scottbez1/Grbl_Esp32/electronics/workbeeController/workbeeController.kicad_pcb

## KiCad design electronics/workbeeController/workbeeController.kicad_pcb (2020-12-29)

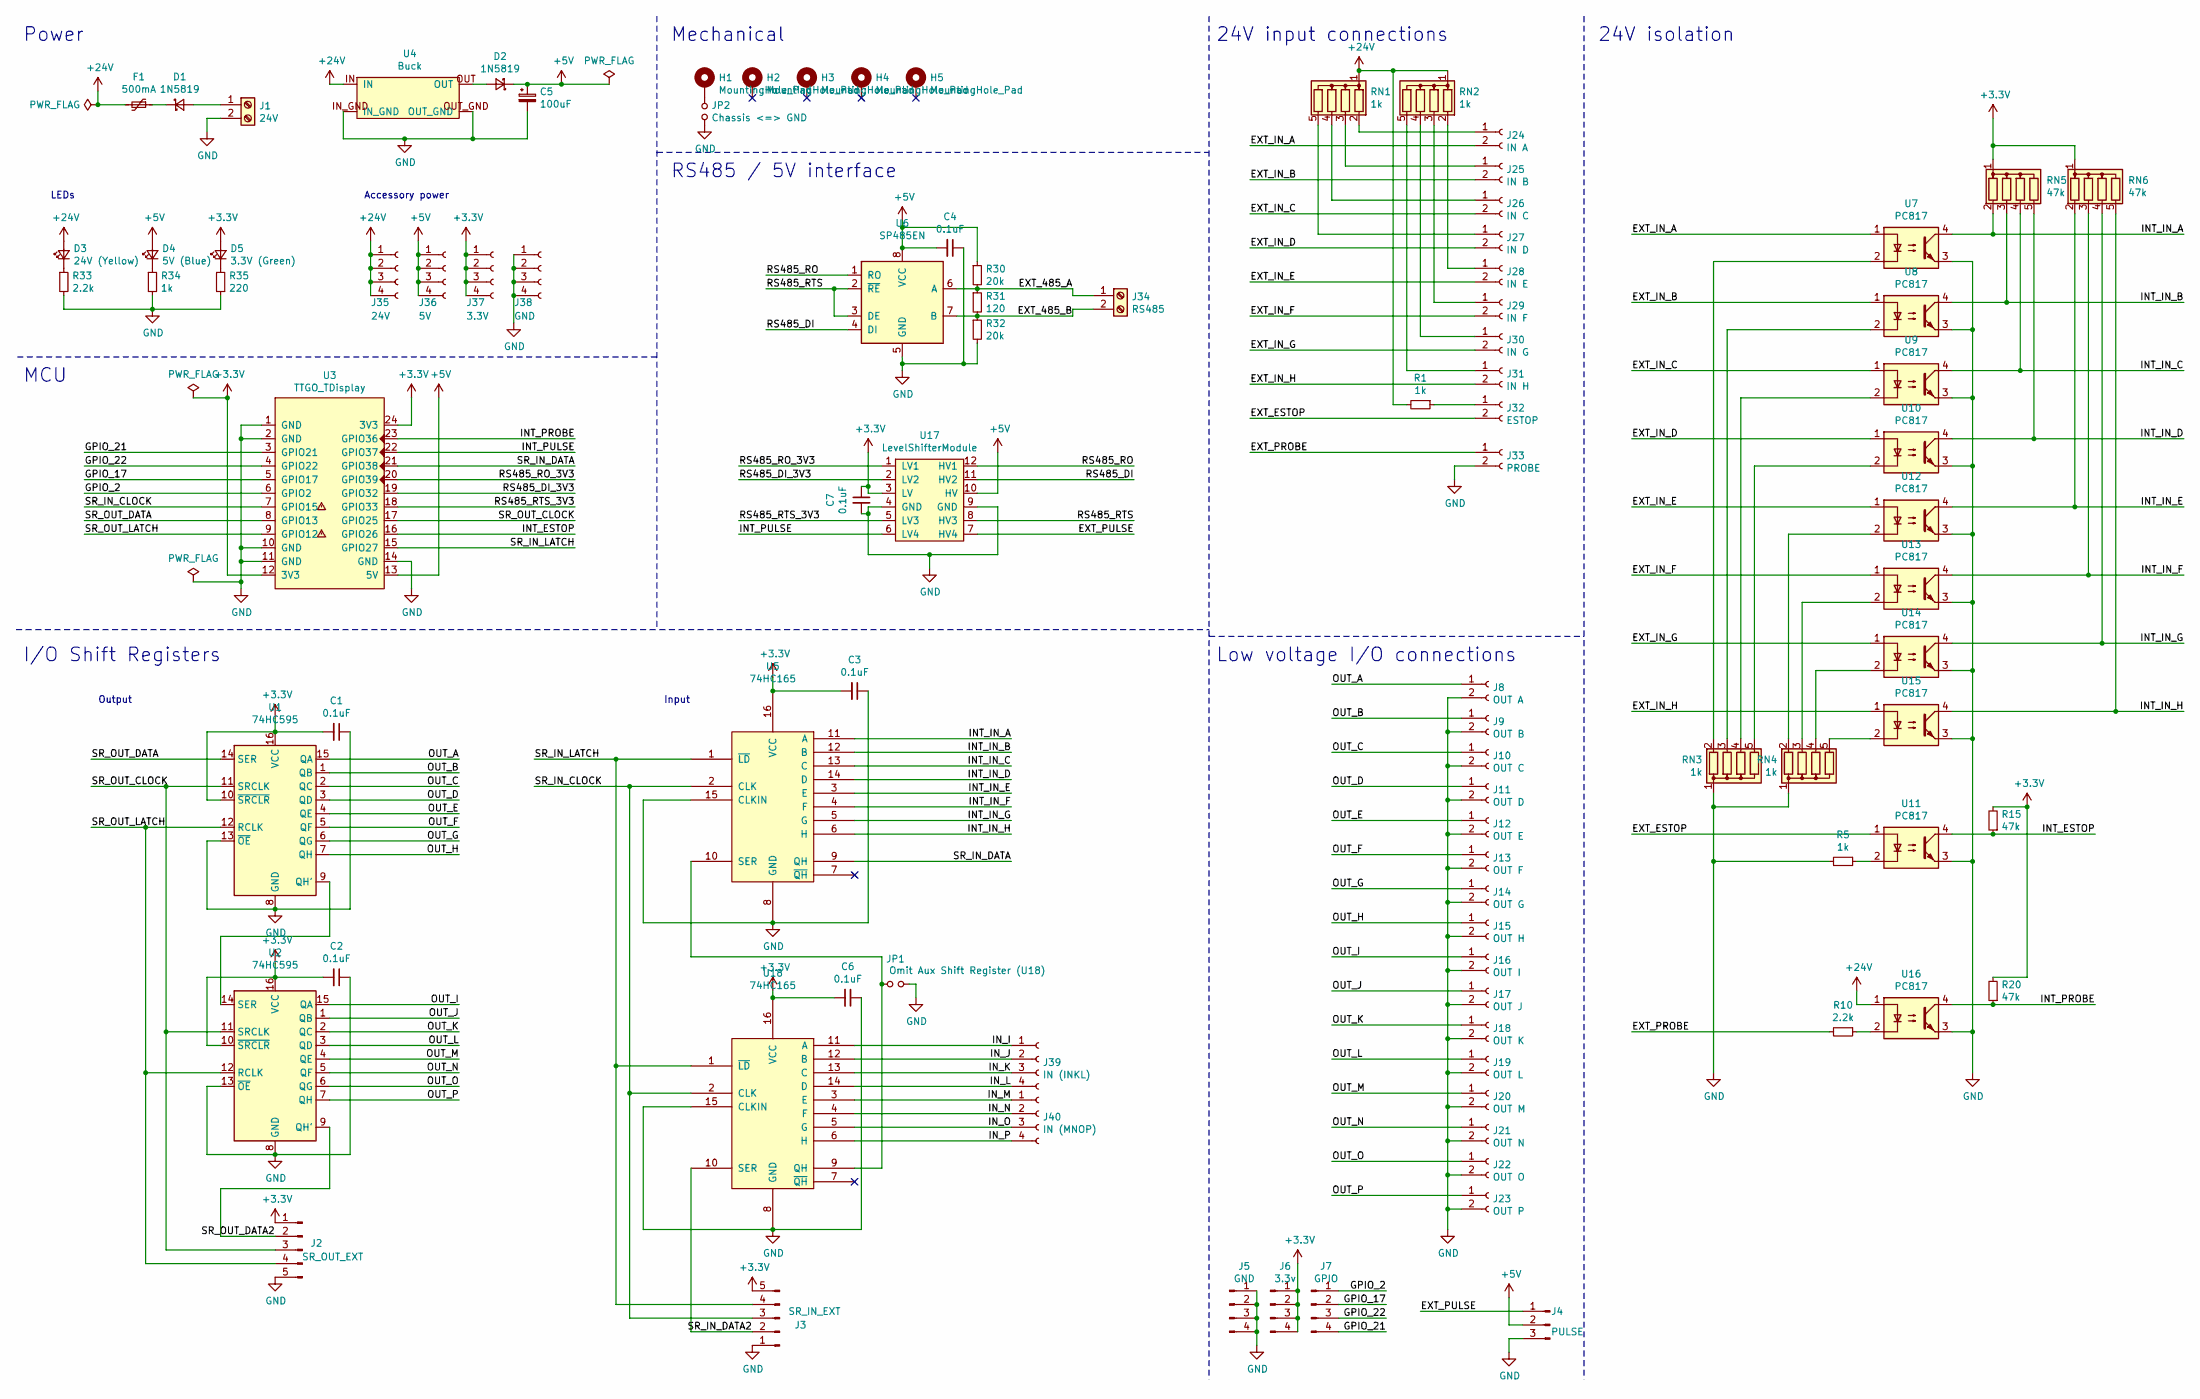
[picture p1: schematic workbeeController.sch]

Parts:
C1, C2, C3, C4, C6, C7: 0.1uF; C_Disc_D5.0mm_W2.5mm_P2.50mm
C5: 100uF; CP_Radial_D8.0mm_P3.50mm
D1, D2: 1N5819; D_DO-41_SOD81_P7.62mm_Horizontal
D3: 24V (Yellow); LED_D3.0mm
D4: 5V (Blue); LED_D3.0mm
D5: 3.3V (Green); LED_D3.0mm
F1: 500mA; C_Disc_D10.5mm_W5.0mm_P5.00mm
H1, H2, H3, H4, H5: MountingHole_Pad; MountingHole_4.3mm_M4_ISO7380_Pad
J1: 24V; 057-EB21A-02-D
J2: SR_OUT_EXT; PinHeader_1x05_P2.54mm_Vertical
J3: SR_IN_EXT; PinHeader_1x05_P2.54mm_Vertical
J4: PULSE; PinHeader_1x03_P2.54mm_Vertical
J5: GND; PinHeader_1x04_P2.54mm_Vertical
J6: 3.3v; PinHeader_1x04_P2.54mm_Vertical
J7: GPIO; PinHeader_1x04_P2.54mm_Vertical
J8: OUT A; PinSocket_1x02_P2.54mm_Vertical
J9: OUT B; PinSocket_1x02_P2.54mm_Vertical
J10: OUT C; PinSocket_1x02_P2.54mm_Vertical
J11: OUT D; PinSocket_1x02_P2.54mm_Vertical
J12: OUT E; PinSocket_1x02_P2.54mm_Vertical
J13: OUT F; PinSocket_1x02_P2.54mm_Vertical
J14: OUT G; PinSocket_1x02_P2.54mm_Vertical
J15: OUT H; PinSocket_1x02_P2.54mm_Vertical
J16: OUT I; PinSocket_1x02_P2.54mm_Vertical
J17: OUT J; PinSocket_1x02_P2.54mm_Vertical
J18: OUT K; PinSocket_1x02_P2.54mm_Vertical
J19: OUT L; PinSocket_1x02_P2.54mm_Vertical
J20: OUT M; PinSocket_1x02_P2.54mm_Vertical
J21: OUT N; PinSocket_1x02_P2.54mm_Vertical
J22: OUT O; PinSocket_1x02_P2.54mm_Vertical
J23: OUT P; PinSocket_1x02_P2.54mm_Vertical
J24: IN A; PinSocket_1x02_P2.54mm_Vertical
J25: IN B; PinSocket_1x02_P2.54mm_Vertical
J26: IN C; PinSocket_1x02_P2.54mm_Vertical
J27: IN D; PinSocket_1x02_P2.54mm_Vertical
J28: IN E; PinSocket_1x02_P2.54mm_Vertical
J29: IN F; PinSocket_1x02_P2.54mm_Vertical
J30: IN G; PinSocket_1x02_P2.54mm_Vertical
J31: IN H; PinSocket_1x02_P2.54mm_Vertical
J32: ESTOP; PinSocket_1x02_P2.54mm_Vertical
J33: PROBE; PinSocket_1x02_P2.54mm_Vertical
J34: RS485; 057-EB21A-02-D
J35: 24V; PinSocket_1x04_P2.54mm_Vertical
J36: 5V; PinSocket_1x04_P2.54mm_Vertical
J37: 3.3V; PinSocket_1x04_P2.54mm_Vertical
J38: GND; PinSocket_1x04_P2.54mm_Vertical
J39: IN (INKL); PinSocket_1x04_P2.54mm_Vertical
J40: IN (MNOP); PinSocket_1x04_P2.54mm_Vertical
JP1: Omit Aux Shift Register (U18); SolderJumper-2_P1.3mm_Open_TrianglePad1.0x1.5mm
JP2: Chassis <=> GND; PinHeader_1x02_P2.54mm_Vertical
R1, R5, R34: 1k; R_Axial_DIN0207_L6.3mm_D2.5mm_P7.62mm_Horizontal
R10, R33: 2.2k; R_Axial_DIN0207_L6.3mm_D2.5mm_P7.62mm_Horizontal
R15, R20: 47k; R_Axial_DIN0207_L6.3mm_D2.5mm_P7.62mm_Horizontal
R30, R32: 20k; R_Axial_DIN0207_L6.3mm_D2.5mm_P7.62mm_Horizontal
R31: 120; R_Axial_DIN0207_L6.3mm_D2.5mm_P7.62mm_Horizontal
R35: 220; R_Axial_DIN0207_L6.3mm_D2.5mm_P7.62mm_Horizontal
RN1, RN2, RN3, RN4: 1k; R_Array_SIP5
RN5, RN6: 47k; R_Array_SIP5
U1, U2: 74HC595; DIP-16_W7.62mm
U3: TTGO_TDisplay; T-DISPLAY
U4: Buck; BuckModule
U5, U18: 74HC165; DIP-16_W7.62mm
U6: SP485EN; SOIC-8_3.9x4.9mm_P1.27mm
U7, U8, U9, U10, U11, U12, U13, U14, U15, U16: PC817; DIP-4_W7.62mm
U17: LevelShifterModule

Connections:
+3V3: C1.2, C2.2, C3.2, C6.2, C7.1, D5.2 (A), J2.1, J3.5, J6.1, J6.2, J6.3, J6.4, J37.1, J37.2, J37.3, J37.4, R15.2, R20.2, RN5.1 (common), RN6.1 (common), U1.10 (~SRCLR), U1.16 (VCC), U2.10 (~SRCLR), U2.16 (VCC), U3.12 (3V3), U3.24 (3V3), U5.16 (VCC), U17.3 (LV), U18.16 (VCC)
+5V: C4.2, C5.1, D2.1 (K), D4.2 (A), J4.2, J36.1, J36.2, J36.3, J36.4, R30.1, U3.13 (5V), U6.8 (VCC), U17.10 (HV)
+24V: D3.2 (A), F1.2, J35.1, J35.2, J35.3, J35.4, R1.2, RN1.1 (common), RN2.1 (common), U4.IN, U16.1
/EXT_485_A: J34.1, R30.2, R31.1, U6.6 (A)
/EXT_485_B: J34.2, R31.2, R32.1, U6.7 (B)
/EXT_ESTOP: J32.2, U11.1
/EXT_IN_A: J24.2, U7.1
/EXT_IN_B: J25.2, U8.1
/EXT_IN_C: J26.2, U9.1
/EXT_IN_D: J27.2, U10.1
/EXT_IN_E: J28.2, U12.1
/EXT_IN_F: J29.2, U13.1
/EXT_IN_G: J30.2, U14.1
/EXT_IN_H: J31.2, U15.1
/EXT_PROBE: J33.1, R10.2
/EXT_PULSE: J4.1, U17.7 (HV4)
/GPIO_2: J7.1, U3.6 (GPIO2)
/GPIO_17: J7.2, U3.5 (GPIO17)
/GPIO_21: J7.4, U3.3 (GPIO21)
/GPIO_22: J7.3, U3.4 (GPIO22)
/INT_ESTOP: R15.1, U3.16 (GPIO26), U11.4
/INT_IN_A: RN5.2 (R1), U5.11 (A), U7.4
/INT_IN_B: RN5.3 (R2), U5.12 (B), U8.4
/INT_IN_C: RN5.4 (R3), U5.13 (C), U9.4
/INT_IN_D: RN5.5 (R4), U5.14 (D), U10.4
/INT_IN_E: RN6.2 (R1), U5.3 (E), U12.4
/INT_IN_F: RN6.3 (R2), U5.4 (F), U13.4
/INT_IN_G: RN6.4 (R3), U5.5 (G), U14.4
/INT_IN_H: RN6.5 (R4), U5.6 (H), U15.4
/INT_PROBE: R20.1, U3.23 (GPIO36), U16.4
/INT_PULSE: U3.22 (GPIO37), U17.6 (LV4)
/IN_I: J39.1, U18.11 (A)
/IN_J: J39.2, U18.12 (B)
/IN_K: J39.3, U18.13 (C)
/IN_L: J39.4, U18.14 (D)
/IN_M: J40.1, U18.3 (E)
/IN_N: J40.2, U18.4 (F)
/IN_O: J40.3, U18.5 (G)
/IN_P: J40.4, U18.6 (H)
/OUT_A: J8.1, U1.15 (QA)
/OUT_B: J9.1, U1.1 (QB)
/OUT_C: J10.1, U1.2 (QC)
/OUT_D: J11.1, U1.3 (QD)
/OUT_E: J12.1, U1.4 (QE)
/OUT_F: J13.1, U1.5 (QF)
/OUT_G: J14.1, U1.6 (QG)
/OUT_H: J15.1, U1.7 (QH)
/OUT_I: J16.1, U2.15 (QA)
/OUT_J: J17.1, U2.1 (QB)
/OUT_K: J18.1, U2.2 (QC)
/OUT_L: J19.1, U2.3 (QD)
/OUT_M: J20.1, U2.4 (QE)
/OUT_N: J21.1, U2.5 (QF)
/OUT_O: J22.1, U2.6 (QG)
/OUT_P: J23.1, U2.7 (QH)
/RS485_DI: U6.4 (DI), U17.11 (HV2)
/RS485_DI_3V3: U3.19 (GPIO32), U17.2 (LV2)
/RS485_RO: U6.1 (RO), U17.12 (HV1)
/RS485_RO_3V3: U3.20 (GPIO39), U17.1 (LV1)
/RS485_RTS: U6.2 (~RE~), U6.3 (DE), U17.8 (HV3)
/RS485_RTS_3V3: U3.18 (GPIO33), U17.5 (LV3)
/SR_IN_CLOCK: J3.3, U3.7 (GPIO15), U5.2 (CLK), U18.2 (CLK)
/SR_IN_DATA: U3.21 (GPIO38), U5.9 (QH)
/SR_IN_DATA2: J3.2, U18.10 (SER)
/SR_IN_LATCH: J3.4, U3.15 (GPIO27), U5.1 (~LD), U18.1 (~LD)
/SR_OUT_CLOCK: J2.3, U1.11 (SRCLK), U2.11 (SRCLK), U3.17 (GPIO25)
/SR_OUT_DATA: U1.14 (SER), U3.8 (GPIO13)
/SR_OUT_DATA2: J2.2, U2.9 (QH')
/SR_OUT_LATCH: J2.4, U1.12 (RCLK), U2.12 (RCLK), U3.9 (GPIO12)
GND: C1.1, C2.1, C3.1, C4.1, C5.2, C6.1, C7.2, J1.2, J2.5, J3.1, J4.3, J5.1, J5.2, J5.3, J5.4, J8.2, J9.2, J10.2, J11.2, J12.2, J13.2, J14.2, J15.2, J16.2, J17.2, J18.2, J19.2, J20.2, J21.2, J22.2, J23.2, J33.2, J38.1, J38.2, J38.3, J38.4, JP1.2, JP2.1, R5.2, R32.2, R33.2, R34.2, R35.2, RN3.1 (common), RN4.1 (common), U1.8 (GND), U1.13 (~OE), U2.8 (GND), U2.13 (~OE), U3.1 (GND), U3.2 (GND), U3.10 (GND), U3.11 (GND), U3.14 (GND), U4.IN_GND, U4.OUT_GND, U5.8 (GND), U5.15 (CLKIN), U6.5 (GND), U7.3, U8.3, U9.3, U10.3, U11.3, U12.3, U13.3, U14.3, U15.3, U16.3, U17.4 (GND), U17.9 (GND), U18.8 (GND), U18.15 (CLKIN)
unnamed: D1.1 (K), F1.1
unnamed: D1.2 (A), J1.1
unnamed: D2.2 (A), U4.OUT
unnamed: D3.1 (K), R33.1
unnamed: D4.1 (K), R34.1
unnamed: D5.1 (K), R35.1
unnamed: H1.1, JP2.2
unnamed: J24.1, RN1.2 (R1)
unnamed: J25.1, RN1.3 (R2)
unnamed: J26.1, RN1.4 (R3)
unnamed: J27.1, RN1.5 (R4)
unnamed: J28.1, RN2.2 (R1)
unnamed: J29.1, RN2.3 (R2)
unnamed: J30.1, RN2.4 (R3)
unnamed: J31.1, RN2.5 (R4)
unnamed: J32.1, R1.1
unnamed: JP1.1, U5.10 (SER), U18.9 (QH)
unnamed: R5.1, U11.2
unnamed: R10.1, U16.2
unnamed: RN3.2 (R1), U7.2
unnamed: RN3.3 (R2), U8.2
unnamed: RN3.4 (R3), U9.2
unnamed: RN3.5 (R4), U10.2
unnamed: RN4.2 (R1), U12.2
unnamed: RN4.3 (R2), U13.2
unnamed: RN4.4 (R3), U14.2
unnamed: RN4.5 (R4), U15.2
unnamed: U1.9 (QH'), U2.14 (SER)

Notes on the sheet:
Power
I/O Shift Registers
MCU
RS485 / 5V interface
24V input connections
Low voltage I/O connections
24V isolation
Accessory power
LEDs
Output
Input
Mechanical

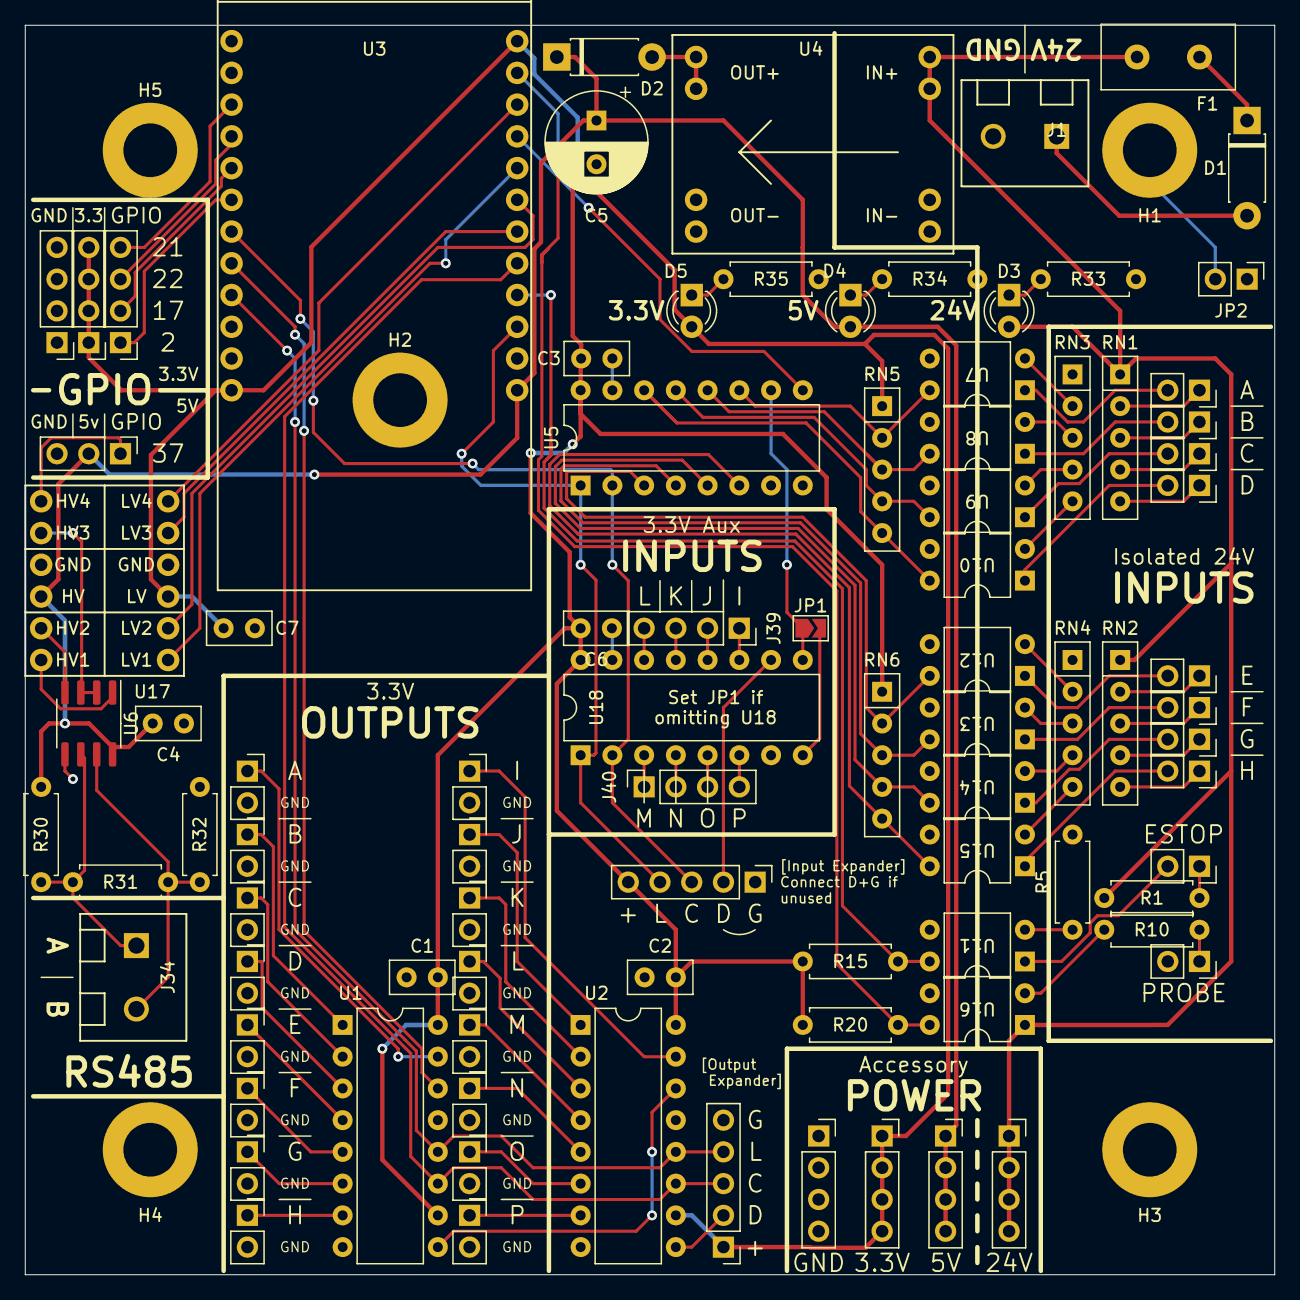
[picture p2: board workbeeController.kicad_pcb from above]

Board: 2 copper layers, 100.0 x 100.0 mm, 95 parts (0 on the bottom side), 98 nets.
