scottbez1/Grbl_Esp32/Grbl_Esp32/src/Defaults.h

#pragma once
#    define DEFAULT_STEP_PULSE_MICROSECONDS 3  // $0
#    define DEFAULT_STEPPER_IDLE_LOCK_TIME 250  // $1 msec (0-254, 255 keeps steppers enabled)
#    define DEFAULT_STEPPING_INVERT_MASK 0  // $2 uint8_t
#    define DEFAULT_DIRECTION_INVERT_MASK 0  // $3 uint8_
#    define DEFAULT_INVERT_ST_ENABLE 0  // $4 boolean
#    define DEFAULT_INVERT_LIMIT_PINS 1  // $5 boolean
#    define DEFAULT_INVERT_PROBE_PIN 0  // $6 boolean
#    define DEFAULT_STATUS_REPORT_MASK 1  // $10
#    define DEFAULT_VERBOSE_ERRORS 0
#    define DEFAULT_JUNCTION_DEVIATION 0.01  // $11 mm
#    define DEFAULT_ARC_TOLERANCE 0.002  // $12 mm
#    define DEFAULT_REPORT_INCHES 0  // $13 false
#    define DEFAULT_SOFT_LIMIT_ENABLE 0  // $20 false
#    define DEFAULT_HARD_LIMIT_ENABLE 0  // $21 false
#    define DEFAULT_HOMING_ENABLE 0  // $22 false
#    define DEFAULT_HOMING_DIR_MASK 3  // $23 move positive dir Z, negative X,Y
#    define DEFAULT_HOMING_FEED_RATE 200.0  // $24 mm/min
#    define DEFAULT_HOMING_SEEK_RATE 2000.0  // $25 mm/min
#    define DEFAULT_HOMING_DEBOUNCE_DELAY 250  // $26 msec (0-65k)
#    define DEFAULT_HOMING_PULLOFF 1.0  // $27 mm
#    define DEFAULT_HOMING_SQUARED_AXES 0
#    define DEFAULT_HOMING_CYCLE_0 bit(Z_AXIS)
#    define DEFAULT_HOMING_CYCLE_1 (bit(X_AXIS) | bit(Y_AXIS))
#    define DEFAULT_HOMING_CYCLE_2 0
#    define DEFAULT_HOMING_CYCLE_3 0
#    define DEFAULT_HOMING_CYCLE_4 0
#    define DEFAULT_HOMING_CYCLE_5 0
#    define SPINDLE_TYPE SpindleType::NONE
#    define DEFAULT_SPINDLE_RPM_MIN 0.0  // rpm
#    define DEFAULT_LASER_MODE 0  // false
#    define DEFAULT_LASER_FULL_POWER 1000
#    define DEFAULT_SPINDLE_RPM_MAX 1000.0  // rpm
#    define DEFAULT_SPINDLE_FREQ 5000.0  // $33 Hz (extended set)
#    define DEFAULT_SPINDLE_OFF_VALUE 0.0  // $34 Percent of full period(extended set)
#    define DEFAULT_SPINDLE_MIN_VALUE 0.0  // $35 Percent of full period (extended set)
#    define DEFAULT_SPINDLE_MAX_VALUE 100.0  // $36 Percent of full period (extended set)
#    define DEFAULT_SPINDLE_DELAY_SPINUP 0
#    define DEFAULT_SPINDLE_DELAY_SPINDOWN 0
#    define DEFAULT_INVERT_SPINDLE_OUTPUT_PIN 0
#    define DEFAULT_INVERT_SPINDLE_ENABLE_PIN 0
#    define DEFAULT_SPINDLE_ENABLE_OFF_WITH_ZERO_SPEED 0
#    define DEFAULT_USER_INT_80 0  // $80 User integer setting
#    define DEFAULT_USER_INT_81 0  // $81 User integer setting
#    define DEFAULT_USER_INT_82 0  // $82 User integer setting
#    define DEFAULT_USER_INT_83 0  // $83 User integer setting
#    define DEFAULT_USER_INT_84 0  // $84 User integer setting
#    define DEFAULT_USER_FLOAT_90 0.0  // $90 User integer setting
#    define DEFAULT_USER_FLOAT_91 0.0  // $92 User integer setting
#    define DEFAULT_USER_FLOAT_92 0.0  // $92 User integer setting
#    define DEFAULT_USER_FLOAT_93 0.0  // $93 User integer setting
#    define DEFAULT_USER_FLOAT_94 0.0  // $94 User integer setting
#    define DEFAULT_X_STEPS_PER_MM 100.0
#    define DEFAULT_Y_STEPS_PER_MM 100.0
#    define DEFAULT_Z_STEPS_PER_MM 100.0
#    define DEFAULT_A_STEPS_PER_MM 100.0
#    define DEFAULT_B_STEPS_PER_MM 100.0
#    define DEFAULT_C_STEPS_PER_MM 100.0
#    define DEFAULT_X_MAX_RATE 1000.0  // mm/min
#    define DEFAULT_Y_MAX_RATE 1000.0  // mm/min
#    define DEFAULT_Z_MAX_RATE 1000.0  // mm/min
#    define DEFAULT_A_MAX_RATE 1000.0  // mm/min
#    define DEFAULT_B_MAX_RATE 1000.0  // mm/min
#    define DEFAULT_C_MAX_RATE 1000.0  // mm/min
#define SEC_PER_MIN_SQ (60.0 * 60.0)  // Seconds Per Minute Squared, for acceleration conversion
#    define DEFAULT_X_ACCELERATION 200.0
#    define DEFAULT_Y_ACCELERATION 200.0
#    define DEFAULT_Z_ACCELERATION 200.0
#    define DEFAULT_A_ACCELERATION 200.0
#    define DEFAULT_B_ACCELERATION 200.0
#    define DEFAULT_C_ACCELERATION 200.0
#    define DEFAULT_X_MAX_TRAVEL 300.0  // $130 mm NOTE: Must be a positive value.
#    define DEFAULT_Y_MAX_TRAVEL 300.0  // mm NOTE: Must be a positive value.
#    define DEFAULT_Z_MAX_TRAVEL 300.0  // mm NOTE: Must be a positive value.
#    define DEFAULT_A_MAX_TRAVEL 300.0  // mm NOTE: Must be a positive value.
#    define DEFAULT_B_MAX_TRAVEL 300.0  // mm NOTE: Must be a positive value.
#    define DEFAULT_C_MAX_TRAVEL 300.0  // mm NOTE: Must be a positive value.
#    define DEFAULT_X_HOMING_MPOS 0.0
#    define DEFAULT_Y_HOMING_MPOS 0.0
#    define DEFAULT_Z_HOMING_MPOS 0.0
#    define DEFAULT_A_HOMING_MPOS 0.0
#    define DEFAULT_B_HOMING_MPOS 0.0
#    define DEFAULT_C_HOMING_MPOS 0.0
#    define DEFAULT_X_CURRENT 0.25  // $140 current in amps (extended set)
#    define DEFAULT_Y_CURRENT 0.25  // $141 current in amps (extended set)
#    define DEFAULT_Z_CURRENT 0.25  // $142 current in amps (extended set)
#    define DEFAULT_A_CURRENT 0.25  // $143 current in amps (extended set)
#    define DEFAULT_B_CURRENT 0.25  // $144 current in amps (extended set)
#    define DEFAULT_C_CURRENT 0.25  // $145 current in amps (extended set)
#    define DEFAULT_X_HOLD_CURRENT 0.125  // $150 current in amps (extended set)
#    define DEFAULT_Y_HOLD_CURRENT 0.125  // $151 current in amps (extended set)
#    define DEFAULT_Z_HOLD_CURRENT 0.125  // $152 current in amps (extended set)
#    define DEFAULT_A_HOLD_CURRENT 0.125  // $153 current in amps (extended set)
#    define DEFAULT_B_HOLD_CURRENT 0.125  // $154 current in amps (extended set)
#    define DEFAULT_C_HOLD_CURRENT 0.125  // $154 current in amps (extended set)
#    define DEFAULT_X_MICROSTEPS 16  // $160 micro steps (extended set)
#    define DEFAULT_Y_MICROSTEPS 16  // $161 micro steps (extended set)
#    define DEFAULT_Z_MICROSTEPS 16  // $162 micro steps (extended set)
#    define DEFAULT_A_MICROSTEPS 16  // $163 micro steps (extended set)
#    define DEFAULT_B_MICROSTEPS 16  // $164 micro steps (extended set)
#    define DEFAULT_C_MICROSTEPS 16  // $165 micro steps (extended set)
#    define DEFAULT_X_STALLGUARD 16  // $170 stallguard (extended set)
#    define DEFAULT_Y_STALLGUARD 16  // $171 stallguard (extended set)
#    define DEFAULT_Z_STALLGUARD 16  // $172 stallguard (extended set)
#    define DEFAULT_A_STALLGUARD 16  // $173 stallguard (extended set)
#    define DEFAULT_B_STALLGUARD 16  // $174 stallguard (extended set)
#    define DEFAULT_C_STALLGUARD 16  // $175 stallguard (extended set)
#    define SDCARD_DET_PIN UNDEFINED_PIN
#    define STEPPERS_DISABLE_PIN UNDEFINED_PIN
#    define X_DISABLE_PIN UNDEFINED_PIN
#    define Y_DISABLE_PIN UNDEFINED_PIN
#    define Z_DISABLE_PIN UNDEFINED_PIN
#    define A_DISABLE_PIN UNDEFINED_PIN
#    define B_DISABLE_PIN UNDEFINED_PIN
#    define C_DISABLE_PIN UNDEFINED_PIN
#    define X2_DISABLE_PIN UNDEFINED_PIN
#    define Y2_DISABLE_PIN UNDEFINED_PIN
#    define Z2_DISABLE_PIN UNDEFINED_PIN
#    define A2_DISABLE_PIN UNDEFINED_PIN
#    define B2_DISABLE_PIN UNDEFINED_PIN
#    define C2_DISABLE_PIN UNDEFINED_PIN
#    define X_LIMIT_PIN UNDEFINED_PIN
#    define Y_LIMIT_PIN UNDEFINED_PIN
#    define Z_LIMIT_PIN UNDEFINED_PIN
#    define A_LIMIT_PIN UNDEFINED_PIN
#    define B_LIMIT_PIN UNDEFINED_PIN
#    define C_LIMIT_PIN UNDEFINED_PIN
#    define X2_LIMIT_PIN UNDEFINED_PIN
#    define Y2_LIMIT_PIN UNDEFINED_PIN
#    define Z2_LIMIT_PIN UNDEFINED_PIN
#    define A2_LIMIT_PIN UNDEFINED_PIN
#    define B2_LIMIT_PIN UNDEFINED_PIN
#    define C2_LIMIT_PIN UNDEFINED_PIN
#    define X_STEPPER_MS3 UNDEFINED_PIN
#    define Y_STEPPER_MS3 UNDEFINED_PIN
#    define Z_STEPPER_MS3 UNDEFINED_PIN
#    define A_STEPPER_MS3 UNDEFINED_PIN
#    define B_STEPPER_MS3 UNDEFINED_PIN
#    define C_STEPPER_MS3 UNDEFINED_PIN
#    define X2_STEPPER_MS3 UNDEFINED_PIN
#    define Y2_STEPPER_MS3 UNDEFINED_PIN
#    define Z2_STEPPER_MS3 UNDEFINED_PIN
#    define A2_STEPPER_MS3 UNDEFINED_PIN
#    define B2_STEPPER_MS3 UNDEFINED_PIN
#    define C2_STEPPER_MS3 UNDEFINED_PIN
#    define SERVO_TIMER_INTERVAL 75.0  // Hz This is the update inveral in milliseconds
#    define DYNAMIXEL_TXD UNDEFINED_PIN
#    define DYNAMIXEL_RXD UNDEFINED_PIN
#    define DYNAMIXEL_RTS UNDEFINED_PIN
#    define USER_DIGITAL_PIN_0 UNDEFINED_PIN
#    define USER_DIGITAL_PIN_1 UNDEFINED_PIN
#    define USER_DIGITAL_PIN_2 UNDEFINED_PIN
#    define USER_DIGITAL_PIN_3 UNDEFINED_PIN
#    define USER_ANALOG_PIN_0 UNDEFINED_PIN
#    define USER_ANALOG_PIN_1 UNDEFINED_PIN
#    define USER_ANALOG_PIN_2 UNDEFINED_PIN
#    define USER_ANALOG_PIN_3 UNDEFINED_PIN
#    define PROBE_PIN UNDEFINED_PIN
#    define USER_ANALOG_PIN_0_FREQ 5000
#    define USER_ANALOG_PIN_1_FREQ 5000
#    define USER_ANALOG_PIN_2_FREQ 5000
#    define USER_ANALOG_PIN_3_FREQ 5000
#    define DEFAULT_USER_MACRO0 ""
#    define DEFAULT_USER_MACRO1 ""
#    define DEFAULT_USER_MACRO2 ""
#    define DEFAULT_USER_MACRO3 ""
