scottbez1/Grbl_Esp32/Grbl_Esp32/src/Machines/workbee.h

#pragma once
// clang-format off

/*
    workbee.h
    Part of Grbl_ESP32

    2018    - Bart Dring
    2020    - Mitch Bradley
    2020    - Scott Bezek

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
    You should have received a copy of the GNU General Public License
    along with Grbl_ESP32.  If not, see <http://www.gnu.org/licenses/>.
*/

#define MACHINE_NAME            "Workbee"

#define USE_MACHINE_INIT


// I2S (steppers & other output-only pins)
#define USE_I2S_OUT
#define USE_I2S_STEPS
#define I2S_OUT_BCK             GPIO_NUM_25
#define I2S_OUT_WS              GPIO_NUM_12
#define I2S_OUT_DATA            GPIO_NUM_13


#define USE_SPI_IN
#define SPI_IN_CLOCK            GPIO_NUM_15
#define SPI_IN_DATA             GPIO_NUM_38
#define SPI_IN_LATCH            GPIO_NUM_27
#define SPI_IN_CLOCK_SPEED_HZ   4000000
#define SPI_IN_DMA_CHANNEL      1
#define SPI_IN_HOST             HSPI_HOST // Note: must use HSPI to avoid conflict with ST7789 driver which uses VSPI

// #define ENABLE_CONTROL_SW_DEBOUNCE
// #define ENABLE_SOFTWARE_DEBOUNCE

// ***** IO *****
#define X_STEP_PIN              I2SO(0)
#define X_DIRECTION_PIN         I2SO(1)
#define Y_STEP_PIN              I2SO(2)
#define Y_DIRECTION_PIN         I2SO(3)
#define Y2_STEP_PIN             I2SO(4)
#define Y2_DIRECTION_PIN        I2SO(5)
#define Z_STEP_PIN              I2SO(6)
#define Z_DIRECTION_PIN         I2SO(7)

#define SPINDLE_TYPE                    SpindleType::HUANYANG
#define VFD_RS485_TXD_PIN               GPIO_NUM_32
#define VFD_RS485_RXD_PIN               GPIO_NUM_39
#define VFD_RS485_RTS_PIN               GPIO_NUM_33
#define VFD_RS485_ADDR                  1
#define DEFAULT_SPINDLE_RPM_MIN         8000.0
#define DEFAULT_SPINDLE_RPM_MAX         24000.0
#define DEFAULT_SPINDLE_DELAY_SPINUP    10000
#define DEFAULT_SPINDLE_DELAY_SPINDOWN  5000

#define SPINDLE_COOLANT_FLOW_PULSE_PIN  GPIO_NUM_37
#define SPINDLE_COOLANT_FLOW_PULSE_UNIT PCNT_UNIT_0

// To debug RS485 spindle comms:
// #define VFD_DEBUG_MODE

#define X_LIMIT_PIN                 SPII(0)
#define Y_LIMIT_PIN                 SPII(1)
#define Y2_LIMIT_PIN                SPII(2)
#define Z_LIMIT_PIN                 SPII(3)
#define DEFAULT_INVERT_LIMIT_PINS   0

#define ESTOP_PIN                   GPIO_NUM_26

#define PROBE_PIN                   GPIO_NUM_36


#define CONTROL_SAFETY_DOOR_PIN     SPII(4)
#define CONTROL_RESET_PIN           SPII(5)
#define CONTROL_FEED_HOLD_PIN       SPII(6)
#define CONTROL_CYCLE_START_PIN     SPII(7)

// The default value in config.h is wrong for this controller
#ifdef INVERT_CONTROL_PIN_MASK
    #undef INVERT_CONTROL_PIN_MASK
#endif
#define INVERT_CONTROL_PIN_MASK B1110


// ***** MACHINE BOUNDS *****
#define DEFAULT_X_MAX_TRAVEL 800.0 // mm
#define DEFAULT_Y_MAX_TRAVEL 1275.0 // mm
#define DEFAULT_Z_MAX_TRAVEL 118.0 // mm

#define DEFAULT_SOFT_LIMIT_ENABLE 1
#define DEFAULT_HARD_LIMIT_ENABLE 0


// ***** MOVEMENT *****
// Invert Y axis
#define DEFAULT_DIRECTION_INVERT_MASK 0b000010

#define DEFAULT_X_STEPS_PER_MM 100.0
#define DEFAULT_Y_STEPS_PER_MM 100.0
#define DEFAULT_Z_STEPS_PER_MM 100.0

#define DEFAULT_X_MAX_RATE 4000.0 // mm/min
#define DEFAULT_Y_MAX_RATE 4000.0 // mm/min
#define DEFAULT_Z_MAX_RATE 3000.0 // mm/min

#define DEFAULT_X_ACCELERATION 500.0 // mm/sec^2
#define DEFAULT_Y_ACCELERATION 500.0 // mm/sec^2
#define DEFAULT_Z_ACCELERATION 100.0 // mm/sec^2


#define PARKING_ENABLE  // Default disabled. Uncomment to enable
#define PARKING_AXIS Z_AXIS                      // Define which axis that performs the parking motion


#define DEFAULT_HOMING_ENABLE           1
#define DEFAULT_HOMING_SQUARED_AXES     (bit(Y_AXIS))
#define DEFAULT_HOMING_DIR_MASK         (bit(X_AXIS))
#define DEFAULT_HOMING_FEED_RATE        100.0 // mm/min
#define DEFAULT_HOMING_SEEK_RATE        2000.0 // mm/min
#define DEFAULT_HOMING_DEBOUNCE_DELAY   25 // msec (0-65k)
#define DEFAULT_HOMING_PULLOFF          2.0 // mm

#define DEFAULT_HOMING_CYCLE_0 (bit(Z_AXIS))  // Raise/home Z before XY motion
#define DEFAULT_HOMING_CYCLE_1 (bit(X_AXIS))  // Home X
#define DEFAULT_HOMING_CYCLE_2 (bit(Y_AXIS))  // Home and sqaure the Y axis (must be done separately from X for squaring)
#define DEFAULT_HOMING_CYCLE_3 0
