scottbez1/Grbl_Esp32/Grbl_Esp32/src/MotionControl.cpp

/*
  MotionControl.cpp - high level interface for issuing motion commands
  Part of Grbl

  Copyright (c) 2011-2016 Sungeun K. Jeon for Gnea Research LLC
  Copyright (c) 2009-2011 Simen Svale Skogsrud

	2018 -	Bart Dring This file was modifed for use on the ESP32
					CPU. Do not use this with Grbl for atMega328P

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
  You should have received a copy of the GNU General Public License
  along with Grbl.  If not, see <http://www.gnu.org/licenses/>.
*/

#include "Grbl.h"

// M_PI is not defined in standard C/C++ but some compilers
// support it anyway.  The following suppresses Intellisense
// problem reports.
#ifndef M_PI
#    define M_PI 3.14159265358979323846
#endif

SquaringMode ganged_mode = SquaringMode::Dual;

// this allows kinematics to be used.
void mc_line_kins(float* target, plan_line_data_t* pl_data, float* position) {
#ifndef USE_KINEMATICS
    mc_line(target, pl_data);
#else  // else use kinematics
    inverse_kinematics(target, pl_data, position);
#endif
}

// Execute linear motion in absolute millimeter coordinates. Feed rate given in millimeters/second
// unless invert_feed_rate is true. Then the feed_rate means that the motion should be completed in
// (1 minute)/feed_rate time.
// NOTE: This is the primary gateway to the grbl planner. All line motions, including arc line
// segments, must pass through this routine before being passed to the planner. The seperation of
// mc_line and plan_buffer_line is done primarily to place non-planner-type functions from being
// in the planner and to let backlash compensation or canned cycle integration simple and direct.
void mc_line(float* target, plan_line_data_t* pl_data) {
    // If enabled, check for soft limit violations. Placed here all line motions are picked up
    // from everywhere in Grbl.
    if (soft_limits->get()) {
        // NOTE: Block jog state. Jogging is a special case and soft limits are handled independently.
        if (sys.state != State::Jog) {
            limits_soft_check(target);
        }
    }
    // If in check gcode mode, prevent motion by blocking planner. Soft limits still work.
    if (sys.state == State::CheckMode) {
        return;
    }
    // NOTE: Backlash compensation may be installed here. It will need direction info to track when
    // to insert a backlash line motion(s) before the intended line motion and will require its own
    // plan_check_full_buffer() and check for system abort loop. Also for position reporting
    // backlash steps will need to be also tracked, which will need to be kept at a system level.
    // There are likely some other things that will need to be tracked as well. However, we feel
    // that backlash compensation should NOT be handled by Grbl itself, because there are a myriad
    // of ways to implement it and can be effective or ineffective for different CNC machines. This
    // would be better handled by the interface as a post-processor task, where the original g-code
    // is translated and inserts backlash motions that best suits the machine.
    // NOTE: Perhaps as a middle-ground, all that needs to be sent is a flag or special command that
    // indicates to Grbl what is a backlash compensation motion, so that Grbl executes the move but
    // doesn't update the machine position values. Since the position values used by the g-code
    // parser and planner are separate from the system machine positions, this is doable.
    // If the buffer is full: good! That means we are well ahead of the robot.
    // Remain in this loop until there is room in the buffer.
    do {
        protocol_execute_realtime();  // Check for any run-time commands
        if (sys.abort) {
            return;  // Bail, if system abort.
        }
        if (plan_check_full_buffer()) {
            protocol_auto_cycle_start();  // Auto-cycle start when buffer is full.
        } else {
            break;
        }
    } while (1);
    // Plan and queue motion into planner buffer
    // uint8_t plan_status; // Not used in normal operation.
    plan_buffer_line(target, pl_data);
}

// Execute an arc in offset mode format. position == current xyz, target == target xyz,
// offset == offset from current xyz, axis_X defines circle plane in tool space, axis_linear is
// the direction of helical travel, radius == circle radius, isclockwise boolean. Used
// for vector transformation direction.
// The arc is approximated by generating a huge number of tiny, linear segments. The chordal tolerance
// of each segment is configured in the arc_tolerance setting, which is defined to be the maximum normal
// distance from segment to the circle when the end points both lie on the circle.
void mc_arc(float*            target,
            plan_line_data_t* pl_data,
            float*            position,
            float*            offset,
            float             radius,
            uint8_t           axis_0,
            uint8_t           axis_1,
            uint8_t           axis_linear,
            uint8_t           is_clockwise_arc) {
    float center_axis0 = position[axis_0] + offset[axis_0];
    float center_axis1 = position[axis_1] + offset[axis_1];
    float r_axis0      = -offset[axis_0];  // Radius vector from center to current location
    float r_axis1      = -offset[axis_1];
    float rt_axis0     = target[axis_0] - center_axis0;
    float rt_axis1     = target[axis_1] - center_axis1;

    float previous_position[MAX_N_AXIS] = { 0.0, 0.0, 0.0, 0.0, 0.0, 0.0 };
#ifdef USE_KINEMATICS

    uint16_t n;
    auto     n_axis = number_axis->get();
    for (n = 0; n < n_axis; n++) {
        previous_position[n] = position[n];
    }
#endif
    // CCW angle between position and target from circle center. Only one atan2() trig computation required.
    float angular_travel = atan2(r_axis0 * rt_axis1 - r_axis1 * rt_axis0, r_axis0 * rt_axis0 + r_axis1 * rt_axis1);
    if (is_clockwise_arc) {  // Correct atan2 output per direction
        if (angular_travel >= -ARC_ANGULAR_TRAVEL_EPSILON) {
            angular_travel -= 2 * M_PI;
        }
    } else {
        if (angular_travel <= ARC_ANGULAR_TRAVEL_EPSILON) {
            angular_travel += 2 * M_PI;
        }
    }
    // NOTE: Segment end points are on the arc, which can lead to the arc diameter being smaller by up to
    // (2x) arc_tolerance. For 99% of users, this is just fine. If a different arc segment fit
    // is desired, i.e. least-squares, midpoint on arc, just change the mm_per_arc_segment calculation.
    // For the intended uses of Grbl, this value shouldn't exceed 2000 for the strictest of cases.
    uint16_t segments = floor(fabs(0.5 * angular_travel * radius) / sqrt(arc_tolerance->get() * (2 * radius - arc_tolerance->get())));
    if (segments) {
        // Multiply inverse feed_rate to compensate for the fact that this movement is approximated
        // by a number of discrete segments. The inverse feed_rate should be correct for the sum of
        // all segments.
        if (pl_data->motion.inverseTime) {
            pl_data->feed_rate *= segments;
            pl_data->motion.inverseTime = 0;  // Force as feed absolute mode over arc segments.
        }
        float theta_per_segment  = angular_travel / segments;
        float linear_per_segment = (target[axis_linear] - position[axis_linear]) / segments;
        /* Vector rotation by transformation matrix: r is the original vector, r_T is the rotated vector,
           and phi is the angle of rotation. Solution approach by Jens Geisler.
               r_T = [cos(phi) -sin(phi);
                      sin(phi)  cos(phi] * r ;

           For arc generation, the center of the circle is the axis of rotation and the radius vector is
           defined from the circle center to the initial position. Each line segment is formed by successive
           vector rotations. Single precision values can accumulate error greater than tool precision in rare
           cases. So, exact arc path correction is implemented. This approach avoids the problem of too many very
           expensive trig operations [sin(),cos(),tan()] which can take 100-200 usec each to compute.

           Small angle approximation may be used to reduce computation overhead further. A third-order approximation
           (second order sin() has too much error) holds for most, if not, all CNC applications. Note that this
           approximation will begin to accumulate a numerical drift error when theta_per_segment is greater than
           ~0.25 rad(14 deg) AND the approximation is successively used without correction several dozen times. This
           scenario is extremely unlikely, since segment lengths and theta_per_segment are automatically generated
           and scaled by the arc tolerance setting. Only a very large arc tolerance setting, unrealistic for CNC
           applications, would cause this numerical drift error. However, it is best to set N_ARC_CORRECTION from a
           low of ~4 to a high of ~20 or so to avoid trig operations while keeping arc generation accurate.

           This approximation also allows mc_arc to immediately insert a line segment into the planner
           without the initial overhead of computing cos() or sin(). By the time the arc needs to be applied
           a correction, the planner should have caught up to the lag caused by the initial mc_arc overhead.
           This is important when there are successive arc motions.
        */
        // Computes: cos_T = 1 - theta_per_segment^2/2, sin_T = theta_per_segment - theta_per_segment^3/6) in ~52usec
        float cos_T = 2.0 - theta_per_segment * theta_per_segment;
        float sin_T = theta_per_segment * 0.16666667 * (cos_T + 4.0);
        cos_T *= 0.5;
        float    sin_Ti;
        float    cos_Ti;
        float    r_axisi;
        uint16_t i;
        uint8_t  count = 0;
        for (i = 1; i < segments; i++) {  // Increment (segments-1).
            if (count < N_ARC_CORRECTION) {
                // Apply vector rotation matrix. ~40 usec
                r_axisi = r_axis0 * sin_T + r_axis1 * cos_T;
                r_axis0 = r_axis0 * cos_T - r_axis1 * sin_T;
                r_axis1 = r_axisi;
                count++;
            } else {
                // Arc correction to radius vector. Computed only every N_ARC_CORRECTION increments. ~375 usec
                // Compute exact location by applying transformation matrix from initial radius vector(=-offset).
                cos_Ti  = cos(i * theta_per_segment);
                sin_Ti  = sin(i * theta_per_segment);
                r_axis0 = -offset[axis_0] * cos_Ti + offset[axis_1] * sin_Ti;
                r_axis1 = -offset[axis_0] * sin_Ti - offset[axis_1] * cos_Ti;
                count   = 0;
            }
            // Update arc_target location
            position[axis_0] = center_axis0 + r_axis0;
            position[axis_1] = center_axis1 + r_axis1;
            position[axis_linear] += linear_per_segment;
#ifdef USE_KINEMATICS
            mc_line_kins(position, pl_data, previous_position);
            previous_position[axis_0]      = position[axis_0];
            previous_position[axis_1]      = position[axis_1];
            previous_position[axis_linear] = position[axis_linear];
#else
            mc_line(position, pl_data);
#endif
            // Bail mid-circle on system abort. Runtime command check already performed by mc_line.
            if (sys.abort) {
                return;
            }
        }
    }
    // Ensure last segment arrives at target location.
    mc_line_kins(target, pl_data, previous_position);
}

// Execute dwell in seconds.
void mc_dwell(float seconds) {
    if (sys.state == State::CheckMode) {
        return;
    }
    protocol_buffer_synchronize();
    delay_sec(seconds, DELAY_MODE_DWELL);
}

// return true if the mask has exactly one bit set,
// so it refers to exactly one axis
static bool mask_is_single_axis(uint8_t axis_mask) {
    // This code depends on the fact that, for binary numberes
    // with only one bit set - and only for such numbers -
    // the bits in one less than the number are disjoint
    // with that bit.  For a number like B100, if you
    // subtract one, the low order 00 bits will have to
    // borrow from the high 1 bit and thus clear it.
    // If any lower bits are 1, then there will be no
    // borrow to clear the highest 1 bit.
    return axis_mask && ((axis_mask & (axis_mask - 1)) == 0);
}

static bool axis_is_squared(uint8_t axis_mask) {
    // Squaring can only be done if it is the only axis in the mask
    if (axis_mask & homing_squared_axes->get()) {
        if (mask_is_single_axis(axis_mask)) {
            return true;
        }
        grbl_msg_sendf(CLIENT_ALL, MsgLevel::Info, "Cannot multi-axis home with squared axes. Homing normally");
        return false;
    }

    return false;
}

#ifdef USE_I2S_STEPS
#    define BACKUP_STEPPER(save_stepper)                                                                                                   \
        do {                                                                                                                               \
            if (save_stepper == ST_I2S_STREAM) {                                                                                           \
                stepper_switch(ST_I2S_STATIC); /* Change the stepper to reduce the delay for accurate probing. */                          \
            }                                                                                                                              \
        } while (0)

#    define RESTORE_STEPPER(save_stepper)                                                                                                  \
        do {                                                                                                                               \
            if (save_stepper == ST_I2S_STREAM && current_stepper != ST_I2S_STREAM) {                                                       \
                stepper_switch(ST_I2S_STREAM); /* Put the stepper back on. */                                                              \
            }                                                                                                                              \
        } while (0)
#else
#    define BACKUP_STEPPER(save_stepper)
#    define RESTORE_STEPPER(save_stepper)
#endif

// Perform homing cycle to locate and set machine zero. Only '$H' executes this command.
// NOTE: There should be no motions in the buffer and Grbl must be in an idle state before
// executing the homing cycle. This prevents incorrect buffered plans after homing.
void mc_homing_cycle(uint8_t cycle_mask) {
    bool no_cycles_defined = true;
#ifdef USE_CUSTOM_HOMING
    if (user_defined_homing(cycle_mask)) {
        return;
    }
#endif
    // This give kinematics a chance to do something before normal homing
    // if it returns true, the homing is canceled.
#ifdef USE_KINEMATICS
    if (kinematics_pre_homing(cycle_mask)) {
        return;
    }
#endif
    // Check and abort homing cycle, if hard limits are already enabled. Helps prevent problems
    // with machines with limits wired on both ends of travel to one limit pin.
    // TODO: Move the pin-specific LIMIT_PIN call to Limits.cpp as a function.
#ifdef LIMITS_TWO_SWITCHES_ON_AXES
    if (limits_get_state()) {
        mc_reset();  // Issue system reset and ensure spindle and coolant are shutdown.
        sys_rt_exec_alarm = ExecAlarm::HardLimit;
        return;
    }
#endif
    limits_disable();  // Disable hard limits pin change register for cycle duration
    // -------------------------------------------------------------------------------------
    // Perform homing routine. NOTE: Special motion case. Only system reset works.
    n_homing_locate_cycle = NHomingLocateCycle;
#ifdef HOMING_SINGLE_AXIS_COMMANDS
    /*
    if (cycle_mask) { limits_go_home(cycle_mask); } // Perform homing cycle based on mask.
    else
    */
    if (cycle_mask) {
        if (!axis_is_squared(cycle_mask)) {
            limits_go_home(cycle_mask);  // Homing cycle 0
        } else {
            ganged_mode           = SquaringMode::Dual;
            n_homing_locate_cycle = 0;  // don't do a second touch cycle
            limits_go_home(cycle_mask);
            ganged_mode           = SquaringMode::A;
            n_homing_locate_cycle = NHomingLocateCycle;  // restore to default value
            limits_go_home(cycle_mask);
            ganged_mode = SquaringMode::B;
            limits_go_home(cycle_mask);
            ganged_mode = SquaringMode::Dual;  // always return to dual
        }
    }  // Perform homing cycle based on mask.
    else
#endif
    {
        for (int cycle = 0; cycle < MAX_N_AXIS; cycle++) {
            auto homing_mask = homing_cycle[cycle]->get();
            if (homing_mask) {  // if there are some axes in this cycle
                no_cycles_defined = false;
                if (!axis_is_squared(homing_mask)) {
                    limits_go_home(homing_mask);  // Homing cycle 0
                } else {
                    ganged_mode           = SquaringMode::Dual;
                    n_homing_locate_cycle = 0;  // don't do a second touch cycle
                    limits_go_home(homing_mask);
                    ganged_mode           = SquaringMode::A;
                    n_homing_locate_cycle = NHomingLocateCycle;  // restore to default value
                    limits_go_home(homing_mask);
                    ganged_mode = SquaringMode::B;
                    limits_go_home(homing_mask);
                    ganged_mode = SquaringMode::Dual;  // always return to dual
                }
            }
        }
        if (no_cycles_defined) {
            report_status_message(Error::HomingNoCycles, CLIENT_ALL);
        }
    }
    protocol_execute_realtime();  // Check for reset and set system abort.
    if (sys.abort) {
        return;  // Did not complete. Alarm state set by mc_alarm.
    }
    // Homing cycle complete! Setup system for normal operation.
    // -------------------------------------------------------------------------------------
    // Sync gcode parser and planner positions to homed position.
    gc_sync_position();
    plan_sync_position();
#ifdef USE_KINEMATICS
    // This give kinematics a chance to do something after normal homing
    kinematics_post_homing();
#endif
    // If hard limits feature enabled, re-enable hard limits pin change register after homing cycle.
    limits_init();
}

// Perform tool length probe cycle. Requires probe switch.
// NOTE: Upon probe failure, the program will be stopped and placed into ALARM state.
GCUpdatePos mc_probe_cycle(float* target, plan_line_data_t* pl_data, uint8_t parser_flags) {
    // TODO: Need to update this cycle so it obeys a non-auto cycle start.
    if (sys.state == State::CheckMode) {
#ifdef SET_CHECK_MODE_PROBE_TO_START
        return GCUpdatePos::None;
#else
        return GCUpdatePos::Target;
#endif
    }
    // Finish all queued commands and empty planner buffer before starting probe cycle.
    protocol_buffer_synchronize();
    if (sys.abort) {
        return GCUpdatePos::None;  // Return if system reset has been issued.
    }

#ifdef USE_I2S_STEPS
    stepper_id_t save_stepper = current_stepper; /* remember the stepper */
#endif
    // Switch stepper mode to the I2S static (realtime mode)
    BACKUP_STEPPER(save_stepper);

    // Initialize probing control variables
    uint8_t is_probe_away = bit_istrue(parser_flags, GCParserProbeIsAway);
    uint8_t is_no_error   = bit_istrue(parser_flags, GCParserProbeIsNoError);
    sys.probe_succeeded   = false;  // Re-initialize probe history before beginning cycle.
    set_probe_direction(is_probe_away);
    // After syncing, check if probe is already triggered. If so, halt and issue alarm.
    // NOTE: This probe initialization error applies to all probing cycles.
    if (probe_get_state() ^ is_probe_away) {  // Check probe pin state.
        sys_rt_exec_alarm = ExecAlarm::ProbeFailInitial;
        protocol_execute_realtime();
        RESTORE_STEPPER(save_stepper);  // Switch the stepper mode to the previous mode
        return GCUpdatePos::None;       // Nothing else to do but bail.
    }
    // Setup and queue probing motion. Auto cycle-start should not start the cycle.
    grbl_msg_sendf(CLIENT_SERIAL, MsgLevel::Info, "Found");
    mc_line_kins(target, pl_data, gc_state.position);
    // Activate the probing state monitor in the stepper module.
    sys_probe_state = Probe::Active;
    // Perform probing cycle. Wait here until probe is triggered or motion completes.
    sys_rt_exec_state.bit.cycleStart = true;
    do {
        protocol_execute_realtime();
        if (sys.abort) {
            RESTORE_STEPPER(save_stepper);  // Switch the stepper mode to the previous mode
            return GCUpdatePos::None;       // Check for system abort
        }
    } while (sys.state != State::Idle);

    // Switch the stepper mode to the previous mode
    RESTORE_STEPPER(save_stepper);

    // Probing cycle complete!
    // Set state variables and error out, if the probe failed and cycle with error is enabled.
    if (sys_probe_state == Probe::Active) {
        if (is_no_error) {
            memcpy(sys_probe_position, sys_position, sizeof(sys_position));
        } else {
            sys_rt_exec_alarm = ExecAlarm::ProbeFailContact;
        }
    } else {
        sys.probe_succeeded = true;  // Indicate to system the probing cycle completed successfully.
    }
    sys_probe_state = Probe::Off;  // Ensure probe state monitor is disabled.
    protocol_execute_realtime();   // Check and execute run-time commands
    // Reset the stepper and planner buffers to remove the remainder of the probe motion.
    st_reset();            // Reset step segment buffer.
    plan_reset();          // Reset planner buffer. Zero planner positions. Ensure probing motion is cleared.
    plan_sync_position();  // Sync planner position to current machine position.
#ifdef MESSAGE_PROBE_COORDINATES
    // All done! Output the probe position as message.
    report_probe_parameters(CLIENT_ALL);
#endif
    if (sys.probe_succeeded) {
        return GCUpdatePos::System;  // Successful probe cycle.
    } else {
        return GCUpdatePos::Target;  // Failed to trigger probe within travel. With or without error.
    }
}

// Plans and executes the single special motion case for parking. Independent of main planner buffer.
// NOTE: Uses the always free planner ring buffer head to store motion parameters for execution.
void mc_parking_motion(float* parking_target, plan_line_data_t* pl_data) {
    if (sys.abort) {
        return;  // Block during abort.
    }
    uint8_t plan_status = plan_buffer_line(parking_target, pl_data);
    if (plan_status) {
        sys.step_control.executeSysMotion = true;
        sys.step_control.endMotion        = false;  // Allow parking motion to execute, if feed hold is active.
        st_parking_setup_buffer();                  // Setup step segment buffer for special parking motion case
        st_prep_buffer();
        st_wake_up();
        do {
            protocol_exec_rt_system();
            if (sys.abort) {
                return;
            }
        } while (sys.step_control.executeSysMotion);
        st_parking_restore_buffer();  // Restore step segment buffer to normal run state.
    } else {
        sys.step_control.executeSysMotion = false;
        protocol_exec_rt_system();
    }
}

#ifdef ENABLE_PARKING_OVERRIDE_CONTROL
void mc_override_ctrl_update(uint8_t override_state) {
    // Finish all queued commands before altering override control state
    protocol_buffer_synchronize();
    if (sys.abort) {
        return;
    }
    sys.override_ctrl = override_state;
}
#endif

// Method to ready the system to reset by setting the realtime reset command and killing any
// active processes in the system. This also checks if a system reset is issued while Grbl
// is in a motion state. If so, kills the steppers and sets the system alarm to flag position
// lost, since there was an abrupt uncontrolled deceleration. Called at an interrupt level by
// realtime abort command and hard limits. So, keep to a minimum.
void mc_reset() {
    // Only this function can set the system reset. Helps prevent multiple kill calls.
    if (!sys_rt_exec_state.bit.reset) {
        sys_rt_exec_state.bit.reset = true;
        // Kill spindle and coolant.
        spindle->stop();
        coolant_stop();

        // turn off all User I/O immediately
        sys_io_control(0xFF, LOW, false);
        sys_pwm_control(0xFF, 0, false);
#ifdef ENABLE_SD_CARD
        // do we need to stop a running SD job?
        if (get_sd_state(false) == SDCARD_BUSY_PRINTING) {
            //Report print stopped
            report_feedback_message(Message::SdFileQuit);
            closeFile();
        }
#endif
        // Kill steppers only if in any motion state, i.e. cycle, actively holding, or homing.
        // NOTE: If steppers are kept enabled via the step idle delay setting, this also keeps
        // the steppers enabled by avoiding the go_idle call altogether, unless the motion state is
        // violated, by which, all bets are off.
        if ((sys.state == State::Cycle || sys.state == State::Homing || sys.state == State::Jog) ||
            (sys.step_control.executeHold || sys.step_control.executeSysMotion)) {
            if (sys.state == State::Homing) {
                if (sys_rt_exec_alarm == ExecAlarm::None) {
                    sys_rt_exec_alarm = ExecAlarm::HomingFailReset;
                }
            } else {
                sys_rt_exec_alarm = ExecAlarm::AbortCycle;
            }
            st_go_idle();  // Force kill steppers. Position has likely been lost.
        }
        ganged_mode = SquaringMode::Dual;  // in case an error occurred during squaring

#ifdef USE_I2S_STEPS
        if (current_stepper == ST_I2S_STREAM) {
            i2s_out_reset();
        }
#endif
    }
}
