scottbez1/Grbl_Esp32/Grbl_Esp32/src/Spindles/DacSpindle.cpp

/*
    DacSpindle.cpp

    This uses the Analog DAC in the ESP32 to generate a voltage
    proportional to the GCode S value desired. Some spindle uses
    a 0-5V or 0-10V value to control the spindle. You would use
    an Op Amp type circuit to get from the 0.3.3V of the ESP32 to that voltage.

    Part of Grbl_ESP32
    2020 -	Bart Dring

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
*/
#include "DacSpindle.h"

namespace Spindles {
    // ======================================== Dac ======================================
    void Dac::init() {
        get_pins_and_settings();

        if (_output_pin == UNDEFINED_PIN) {
            return;
        }

        _min_rpm       = rpm_min->get();
        _max_rpm       = rpm_max->get();
        _pwm_min_value = 0;    // not actually PWM...DAC counts
        _pwm_max_value = 255;  // not actually PWM...DAC counts
        _gpio_ok       = true;

        if (_output_pin != GPIO_NUM_25 && _output_pin != GPIO_NUM_26) {  // DAC can only be used on these pins
            _gpio_ok = false;
            grbl_msg_sendf(CLIENT_ALL, MsgLevel::Info, "DAC spindle pin invalid GPIO_NUM_%d (pin 25 or 26 only)", _output_pin);
            return;
        }

        pinMode(_enable_pin, OUTPUT);
        pinMode(_direction_pin, OUTPUT);

        is_reversable = (_direction_pin != UNDEFINED_PIN);
        use_delays    = true;

        config_message();
    }

    void Dac::config_message() {
        grbl_msg_sendf(CLIENT_ALL,
                       MsgLevel::Info,
                       "DAC spindle Output:%s, Enbl:%s, Dir:%s, Res:8bits",
                       pinName(_output_pin).c_str(),
                       pinName(_enable_pin).c_str(),
                       pinName(_direction_pin).c_str());
    }

    uint32_t Dac::set_rpm(uint32_t rpm) {
        if (_output_pin == UNDEFINED_PIN) {
            return rpm;
        }

        uint32_t pwm_value;

        // apply overrides and limits
        rpm = rpm * sys.spindle_speed_ovr / 100;  // Scale by spindle speed override value (percent)

        // Calculate PWM register value based on rpm max/min settings and programmed rpm.
        if ((_min_rpm >= _max_rpm) || (rpm >= _max_rpm)) {
            // No PWM range possible. Set simple on/off spindle control pin state.
            sys.spindle_speed = _max_rpm;
            pwm_value         = _pwm_max_value;
        } else if (rpm <= _min_rpm) {
            if (rpm == 0) {  // S0 disables spindle
                sys.spindle_speed = 0;
                pwm_value         = 0;
            } else {  // Set minimum PWM output
                rpm               = _min_rpm;
                sys.spindle_speed = rpm;
                pwm_value         = 0;
                grbl_msg_sendf(CLIENT_ALL, MsgLevel::Info, "Spindle RPM less than min RPM:%5.2f %d", rpm, pwm_value);
            }
        } else {
            // Compute intermediate PWM value with linear spindle speed model.
            // NOTE: A nonlinear model could be installed here, if required, but keep it VERY light-weight.
            sys.spindle_speed = rpm;

            pwm_value = map_uint32_t(rpm, _min_rpm, _max_rpm, _pwm_min_value, _pwm_max_value);
        }

        set_output(pwm_value);

        return rpm;
    }

    void Dac::set_output(uint32_t duty) {
        if (_gpio_ok) {
            dacWrite(_output_pin, (uint8_t)duty);
        }
    }
}
