scottbez1/Grbl_Esp32/Grbl_Esp32/src/Limits.cpp

/*
  Limits.cpp - code pertaining to limit-switches and performing the homing cycle
  Part of Grbl

  Copyright (c) 2012-2016 Sungeun K. Jeon for Gnea Research LLC
  Copyright (c) 2009-2011 Simen Svale Skogsrud

	2018 -	Bart Dring This file was modifed for use on the ESP32
					CPU. Do not use this with Grbl for atMega328P
  2018-12-29 - Wolfgang Lienbacher renamed file from limits.h to grbl_limits.h
          fixing ambiguation issues with limit.h in the esp32 Arduino Framework
          when compiling with VS-Code/PlatformIO.

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
  You should have received a copy of the GNU General Public License
  along with Grbl.  If not, see <http://www.gnu.org/licenses/>.
*/

#include "Grbl.h"

uint8_t n_homing_locate_cycle = NHomingLocateCycle;

xQueueHandle limit_sw_queue;  // used by limit switch debouncing

// Homing axis search distance multiplier. Computed by this value times the cycle travel.
#ifndef HOMING_AXIS_SEARCH_SCALAR
#    define HOMING_AXIS_SEARCH_SCALAR 1.1  // Must be > 1 to ensure limit switch will be engaged.
#endif
#ifndef HOMING_AXIS_LOCATE_SCALAR
#    define HOMING_AXIS_LOCATE_SCALAR 5.0  // Must be > 1 to ensure limit switch is cleared.
#endif

void IRAM_ATTR isr_limit_switches() {
    // Ignore limit switches if already in an alarm state or in-process of executing an alarm.
    // When in the alarm state, Grbl should have been reset or will force a reset, so any pending
    // moves in the planner and serial buffers are all cleared and newly sent blocks will be
    // locked out until a homing cycle or a kill lock command. Allows the user to disable the hard
    // limit setting if their limits are constantly triggering after a reset and move their axes.
    if (sys.state != State::Alarm && sys.state != State::Homing) {
        if (sys_rt_exec_alarm == ExecAlarm::None) {
#ifdef ENABLE_SOFTWARE_DEBOUNCE
            // we will start a task that will recheck the switches after a small delay
            int evt;
            xQueueSendFromISR(limit_sw_queue, &evt, NULL);
#else
#    ifdef HARD_LIMIT_FORCE_STATE_CHECK
            // Check limit pin state.
            if (limits_get_state()) {
                mc_reset();                                // Initiate system kill.
                sys_rt_exec_alarm = ExecAlarm::HardLimit;  // Indicate hard limit critical event
            }
#    else
            mc_reset();                                // Initiate system kill.
            sys_rt_exec_alarm = ExecAlarm::HardLimit;  // Indicate hard limit critical event
#    endif
#endif
        }
    }
}

void IRAM_ATTR isr_estop() {
    mc_reset();                                // Initiate system kill.
    sys_rt_exec_alarm = ExecAlarm::HardLimit;  // Indicate hard limit critical event
    int evt;
    xQueueSendFromISR(limit_sw_queue, &evt, NULL);
}

// Homes the specified cycle axes, sets the machine position, and performs a pull-off motion after
// completing. Homing is a special motion case, which involves rapid uncontrolled stops to locate
// the trigger point of the limit switches. The rapid stops are handled by a system level axis lock
// mask, which prevents the stepper algorithm from executing step pulses. Homing motions typically
// circumvent the processes for executing motions in normal operation.
// NOTE: Only the abort realtime command can interrupt this process.
// TODO: Move limit pin-specific calls to a general function for portability.
void limits_go_home(uint8_t cycle_mask) {
    if (sys.abort) {
        return;  // Block if system reset has been issued.
    }
    // Initialize plan data struct for homing motion. Spindle and coolant are disabled.

    // Put motors on axes listed in cycle_mask in homing mode and
    // replace cycle_mask with the list of motors that are ready for homing.
    // Motors with non standard homing can home during motors_set_homing_mode(...)
    cycle_mask = motors_set_homing_mode(cycle_mask, true);  // tell motors homing is about to start

    // see if any motors are left
    if (cycle_mask == 0) {
        return;
    }

    plan_line_data_t  plan_data;
    plan_line_data_t* pl_data = &plan_data;
    memset(pl_data, 0, sizeof(plan_line_data_t));
    pl_data->motion                = {};
    pl_data->motion.systemMotion   = 1;
    pl_data->motion.noFeedOverride = 1;
#ifdef USE_LINE_NUMBERS
    pl_data->line_number = HOMING_CYCLE_LINE_NUMBER;
#endif
    // Initialize variables used for homing computations.
    uint8_t n_cycle = (2 * n_homing_locate_cycle + 1);
    uint8_t step_pin[MAX_N_AXIS];
    float   target[MAX_N_AXIS];
    float   max_travel = 0.0;

    auto n_axis = number_axis->get();
    for (uint8_t idx = 0; idx < n_axis; idx++) {
        // Initialize step pin masks
        step_pin[idx] = bit(idx);
        if (bit_istrue(cycle_mask, bit(idx))) {
            // Set target based on max_travel setting. Ensure homing switches engaged with search scalar.
            max_travel = MAX(max_travel, (HOMING_AXIS_SEARCH_SCALAR)*axis_settings[idx]->max_travel->get());
        }
    }
    // Set search mode with approach at seek rate to quickly engage the specified cycle_mask limit switches.
    bool     approach    = true;
    float    homing_rate = homing_seek_rate->get();
    uint8_t  n_active_axis;
    AxisMask limit_state, axislock;
    do {
        system_convert_array_steps_to_mpos(target, sys_position);
        // Initialize and declare variables needed for homing routine.
        axislock      = 0;
        n_active_axis = 0;
        for (uint8_t idx = 0; idx < n_axis; idx++) {
            // Set target location for active axes and setup computation for homing rate.
            if (bit_istrue(cycle_mask, bit(idx))) {
                n_active_axis++;
                sys_position[idx] = 0;
                // Set target direction based on cycle mask and homing cycle approach state.
                // NOTE: This happens to compile smaller than any other implementation tried.
                auto mask = homing_dir_mask->get();
                if (bit_istrue(mask, bit(idx))) {
                    if (approach) {
                        target[idx] = -max_travel;
                    } else {
                        target[idx] = max_travel;
                    }
                } else {
                    if (approach) {
                        target[idx] = max_travel;
                    } else {
                        target[idx] = -max_travel;
                    }
                }
                // Apply axislock to the step port pins active in this cycle.
                axislock |= step_pin[idx];
            }
        }
        homing_rate *= sqrt(n_active_axis);  // [sqrt(number of active axis)] Adjust so individual axes all move at homing rate.
        sys.homing_axis_lock = axislock;
        // Perform homing cycle. Planner buffer should be empty, as required to initiate the homing cycle.
        pl_data->feed_rate = homing_rate;   // Set current homing rate.
        plan_buffer_line(target, pl_data);  // Bypass mc_line(). Directly plan homing motion.
        sys.step_control                  = {};
        sys.step_control.executeSysMotion = true;  // Set to execute homing motion and clear existing flags.
        st_prep_buffer();                          // Prep and fill segment buffer from newly planned block.
        st_wake_up();                              // Initiate motion
        do {
            if (approach) {
                // Check limit state. Lock out cycle axes when they change.
                limit_state = limits_get_state();
                for (uint8_t idx = 0; idx < n_axis; idx++) {
                    if (axislock & step_pin[idx]) {
                        if (limit_state & bit(idx)) {
                            axislock &= ~(step_pin[idx]);
                        }
                    }
                }
                sys.homing_axis_lock = axislock;
            }
            st_prep_buffer();  // Check and prep segment buffer. NOTE: Should take no longer than 200us.
            // Exit routines: No time to run protocol_execute_realtime() in this loop.
            if (sys_rt_exec_state.bit.safetyDoor || sys_rt_exec_state.bit.reset || cycle_stop) {
                ExecState rt_exec_state;
                rt_exec_state.value = sys_rt_exec_state.value;
                // Homing failure condition: Reset issued during cycle.
                if (rt_exec_state.bit.reset) {
                    sys_rt_exec_alarm = ExecAlarm::HomingFailReset;
                }
                // Homing failure condition: Safety door was opened.
                if (rt_exec_state.bit.safetyDoor) {
                    sys_rt_exec_alarm = ExecAlarm::HomingFailDoor;
                }
                // Homing failure condition: Limit switch still engaged after pull-off motion
                if (!approach && (limits_get_state() & cycle_mask)) {
                    sys_rt_exec_alarm = ExecAlarm::HomingFailPulloff;
                }
                // Homing failure condition: Limit switch not found during approach.
                if (approach && cycle_stop) {
                    sys_rt_exec_alarm = ExecAlarm::HomingFailApproach;
                }

                if (sys_rt_exec_alarm != ExecAlarm::None) {
                    motors_set_homing_mode(cycle_mask, false);  // tell motors homing is done...failed
                    mc_reset();                                 // Stop motors, if they are running.
                    protocol_execute_realtime();
                    return;
                } else {
                    // Pull-off motion complete. Disable CYCLE_STOP from executing.
                    cycle_stop = false;
                    break;
                }
            }
        } while (STEP_MASK & axislock);
#ifdef USE_I2S_STEPS
        if (current_stepper == ST_I2S_STREAM) {
            if (!approach) {
                delay_ms(I2S_OUT_DELAY_MS);
            }
        }
#endif
        st_reset();                        // Immediately force kill steppers and reset step segment buffer.
        delay_ms(homing_debounce->get());  // Delay to allow transient dynamics to dissipate.
        // Reverse direction and reset homing rate for locate cycle(s).
        approach = !approach;
        // After first cycle, homing enters locating phase. Shorten search to pull-off distance.
        if (approach) {
            max_travel  = homing_pulloff->get() * HOMING_AXIS_LOCATE_SCALAR;
            homing_rate = homing_feed_rate->get();
        } else {
            max_travel  = homing_pulloff->get();
            homing_rate = homing_seek_rate->get();
        }
    } while (n_cycle-- > 0);
    // The active cycle axes should now be homed and machine limits have been located. By
    // default, Grbl defines machine space as all negative, as do most CNCs. Since limit switches
    // can be on either side of an axes, check and set axes machine zero appropriately. Also,
    // set up pull-off maneuver from axes limit switches that have been homed. This provides
    // some initial clearance off the switches and should also help prevent them from falsely
    // triggering when hard limits are enabled or when more than one axes shares a limit pin.
    int32_t set_axis_position;
    // Set machine positions for homed limit switches. Don't update non-homed axes.
    auto mask    = homing_dir_mask->get();
    auto pulloff = homing_pulloff->get();
    for (uint8_t idx = 0; idx < n_axis; idx++) {
        auto steps = axis_settings[idx]->steps_per_mm->get();
        if (cycle_mask & bit(idx)) {
            float travel = axis_settings[idx]->max_travel->get();
            float mpos   = axis_settings[idx]->home_mpos->get();

            if (bit_istrue(homing_dir_mask->get(), bit(idx))) {
                sys_position[idx] = (mpos + pulloff) * steps;
            } else {
                sys_position[idx] = (mpos - pulloff) * steps;
            }
        }
    }
    sys.step_control = {};                      // Return step control to normal operation.
    motors_set_homing_mode(cycle_mask, false);  // tell motors homing is done
}

uint8_t limit_pins[MAX_N_AXIS][2] = { { X_LIMIT_PIN, X2_LIMIT_PIN }, { Y_LIMIT_PIN, Y2_LIMIT_PIN }, { Z_LIMIT_PIN, Z2_LIMIT_PIN },
                                      { A_LIMIT_PIN, A2_LIMIT_PIN }, { B_LIMIT_PIN, B2_LIMIT_PIN }, { C_LIMIT_PIN, C2_LIMIT_PIN } };

uint8_t limit_mask = 0;

void limits_init() {
    limit_mask = 0;
    int mode   = INPUT_PULLUP;
#ifdef DISABLE_LIMIT_PIN_PULL_UP
    mode = INPUT;
#endif
    auto n_axis = number_axis->get();
    for (int axis = 0; axis < n_axis; axis++) {
        for (int gang_index = 0; gang_index < 2; gang_index++) {
            uint8_t pin;
            if ((pin = limit_pins[axis][gang_index]) != UNDEFINED_PIN) {
                pinMode(pin, mode);
                limit_mask |= bit(axis);
                if (hard_limits->get()) {
                    attachInterrupt(pin, isr_limit_switches, CHANGE);
                } else {
                    detachInterrupt(pin);
                }

                if (limit_sw_queue == NULL) {
                    grbl_msg_sendf(
                        CLIENT_SERIAL, MsgLevel::Info, "%s limit switch on pin %s", reportAxisNameMsg(axis, gang_index), pinName(pin).c_str());
                }
            }
        }
    }

    // setup task used for debouncing
    if (limit_sw_queue == NULL) {
        limit_sw_queue = xQueueCreate(10, sizeof(int));
        xTaskCreate(limitCheckTask,
                    "limitCheckTask",
                    2048,
                    NULL,
                    5,  // priority
                    NULL);
    }

    pinMode(ESTOP_PIN, INPUT);
    attachInterrupt(ESTOP_PIN, isr_estop, CHANGE);
}

// Disables hard limits.
void limits_disable() {
    auto n_axis = number_axis->get();
    for (int axis = 0; axis < n_axis; axis++) {
        for (int gang_index = 0; gang_index < 2; gang_index++) {
            uint8_t pin = limit_pins[axis][gang_index];
            if (pin != UNDEFINED_PIN) {
                detachInterrupt(pin);
            }
        }
    }
}

// Returns limit state as a bit-wise uint8 variable. Each bit indicates an axis limit, where
// triggered is 1 and not triggered is 0. Invert mask is applied. Axes are defined by their
// number in bit position, i.e. Z_AXIS is bit(2), and Y_AXIS is bit(1).
AxisMask limits_get_state() {
    AxisMask pinMask = 0;
    auto     n_axis  = number_axis->get();
    for (int axis = 0; axis < n_axis; axis++) {
        for (int gang_index = 0; gang_index < 2; gang_index++) {
            uint8_t pin = limit_pins[axis][gang_index];
            if (pin != UNDEFINED_PIN) {
                if (limit_invert->get())
                    pinMask |= (!digitalRead(pin) << axis);
                else
                    pinMask |= (digitalRead(pin) << axis);
            }
        }
    }

#ifdef INVERT_LIMIT_PIN_MASK  // not normally used..unless you have both normal and inverted switches
    pinMask ^= INVERT_LIMIT_PIN_MASK;
#endif
    return pinMask;
}

// Performs a soft limit check. Called from mcline() only. Assumes the machine has been homed,
// the workspace volume is in all negative space, and the system is in normal operation.
// NOTE: Used by jogging to limit travel within soft-limit volume.
void limits_soft_check(float* target) {
    if (limitsCheckTravel(target)) {
        sys.soft_limit = true;
        // Force feed hold if cycle is active. All buffered blocks are guaranteed to be within
        // workspace volume so just come to a controlled stop so position is not lost. When complete
        // enter alarm mode.
        if (sys.state == State::Cycle) {
            sys_rt_exec_state.bit.feedHold = true;
            do {
                protocol_execute_realtime();
                if (sys.abort) {
                    return;
                }
            } while (sys.state != State::Idle);
        }
        mc_reset();                                // Issue system reset and ensure spindle and coolant are shutdown.
        sys_rt_exec_alarm = ExecAlarm::SoftLimit;  // Indicate soft limit critical event
        protocol_execute_realtime();               // Execute to enter critical event loop and system abort
        return;
    }
}

// this is the task
void limitCheckTask(void* pvParameters) {
    while (true) {
        int evt;
        xQueueReceive(limit_sw_queue, &evt, portMAX_DELAY);  // block until receive queue
        vTaskDelay(DEBOUNCE_PERIOD / portTICK_PERIOD_MS);    // delay a while
        AxisMask switch_state;
        switch_state = limits_get_state();
        if (switch_state) {
            //grbl_msg_sendf(CLIENT_SERIAL, MsgLevel::Info, "Limit Switch State %08d", switch_state);
            mc_reset();                                // Initiate system kill.
            sys_rt_exec_alarm = ExecAlarm::HardLimit;  // Indicate hard limit critical event
        }
        if (digitalRead(ESTOP_PIN) == 1) {
            grbl_msg_sendf(CLIENT_SERIAL, MsgLevel::Info, "ESTOP!");
            mc_reset();                                // Initiate system kill.
            sys_rt_exec_alarm = ExecAlarm::HardLimit;  // Indicate hard limit critical event
        }
        static UBaseType_t uxHighWaterMark = 0;
#ifdef DEBUG_TASK_STACK
        reportTaskStackSize(uxHighWaterMark);
#endif
    }
}

float limitsMaxPosition(uint8_t axis) {
    float mpos = axis_settings[axis]->home_mpos->get();

    return bitnum_istrue(homing_dir_mask->get(), axis) ? mpos + axis_settings[axis]->max_travel->get() : mpos;
}

float limitsMinPosition(uint8_t axis) {
    float mpos = axis_settings[axis]->home_mpos->get();

    return bitnum_istrue(homing_dir_mask->get(), axis) ? mpos : mpos - axis_settings[axis]->max_travel->get();
}

// Checks and reports if target array exceeds machine travel limits.
// Return true if exceeding limits
bool limitsCheckTravel(float* target) {
    uint8_t idx;
    auto    n_axis = number_axis->get();
    for (idx = 0; idx < n_axis; idx++) {
        float max_mpos, min_mpos;

        if (target[idx] < limitsMinPosition(idx) || target[idx] > limitsMaxPosition(idx)) {
            return true;
        }
    }
    return false;
}
