scottbez1/Grbl_Esp32/Grbl_Esp32/src/ProcessSettings.cpp

#include "Grbl.h"
#include <map>

// WG Readable and writable as guest
// WU Readable and writable as user and admin
// WA Readable as user and admin, writable as admin

// If authentication is disabled, auth_level will be LEVEL_ADMIN
bool auth_failed(Word* w, const char* value, WebUI::AuthenticationLevel auth_level) {
    permissions_t permissions = w->getPermissions();
    switch (auth_level) {
        case WebUI::AuthenticationLevel::LEVEL_ADMIN:  // Admin can do anything
            return false;                              // Nothing is an Admin auth fail
        case WebUI::AuthenticationLevel::LEVEL_GUEST:  // Guest can only access open settings
            return permissions != WG;                  // Anything other than RG is Guest auth fail
        case WebUI::AuthenticationLevel::LEVEL_USER:   // User is complicated...
            if (!value) {                              // User can read anything
                return false;                          // No read is a User auth fail
            }
            return permissions == WA;  // User cannot write WA
        default:
            return true;
    }
}

void show_setting(const char* name, const char* value, const char* description, WebUI::ESPResponseStream* out) {
    grbl_sendf(out->client(), "$%s=%s", name, value);
    if (description) {
        grbl_sendf(out->client(), "    %s", description);
    }
    grbl_sendf(out->client(), "\r\n");
}

void settings_restore(uint8_t restore_flag) {
#ifdef WIFI_OR_BLUETOOTH
    if (restore_flag & SettingsRestore::Wifi) {
#    ifdef ENABLE_WIFI
        WebUI::wifi_config.reset_settings();
#    endif
#    ifdef ENABLE_BLUETOOTH
        WebUI::bt_config.reset_settings();
#    endif
    }
#endif
    if (restore_flag & SettingsRestore::Defaults) {
        bool restore_startup = restore_flag & SettingsRestore::StartupLines;
        for (Setting* s = Setting::List; s; s = s->next()) {
            if (!s->getDescription()) {
                const char* name = s->getName();
                if (restore_startup) {  // all settings get restored
                    s->setDefault();
                } else if ((strcmp(name, "Line0") != 0) && (strcmp(name, "Line1") != 0)) {  // non startup settings get restored
                    s->setDefault();
                }
            }
        }
        grbl_msg_sendf(CLIENT_SERIAL, MsgLevel::Info, "Settings reset done");
    }
    if (restore_flag & SettingsRestore::Parameters) {
        for (auto idx = CoordIndex::Begin; idx < CoordIndex::End; ++idx) {
            coords[idx]->setDefault();
        }
    }
    grbl_msg_sendf(CLIENT_SERIAL, MsgLevel::Info, "Position offsets reset done");
}

// Get settings values from non volatile storage into memory
void load_settings() {
    for (Setting* s = Setting::List; s; s = s->next()) {
        s->load();
    }
}

extern void make_settings();
extern void make_grbl_commands();

namespace WebUI {
    extern void make_web_settings();
}

void settings_init() {
    make_settings();
    WebUI::make_web_settings();
    make_grbl_commands();
    load_settings();
}

// TODO Settings - jog may need to be special-cased in the parser, since
// it is not really a setting and the entire line needs to be
// sent to gc_execute_line.  It is probably also more time-critical
// than actual settings, which change infrequently, so handling
// it early is probably prudent.
Error jog_set(uint8_t* value, WebUI::AuthenticationLevel auth_level, WebUI::ESPResponseStream* out) {
    // Execute only if in IDLE or JOG states.
    if (sys.state != State::Idle && sys.state != State::Jog) {
        return Error::IdleError;
    }

    // restore the $J= prefix because gc_execute_line() expects it
    const int MAXLINE = 128;
    char      line[MAXLINE];
    strcpy(line, "$J=");
    strncat(line, (char*)value, MAXLINE - strlen("$J=") - 1);

    return gc_execute_line(line, out->client());  // NOTE: $J= is ignored inside g-code parser and used to detect jog motions.
}

Error show_grbl_help(const char* value, WebUI::AuthenticationLevel auth_level, WebUI::ESPResponseStream* out) {
    report_grbl_help(out->client());
    return Error::Ok;
}

Error report_gcode(const char* value, WebUI::AuthenticationLevel auth_level, WebUI::ESPResponseStream* out) {
    report_gcode_modes(out->client());
    return Error::Ok;
}

void show_grbl_settings(WebUI::ESPResponseStream* out, type_t type, bool wantAxis) {
    for (Setting* s = Setting::List; s; s = s->next()) {
        if (s->getType() == type && s->getGrblName()) {
            bool isAxis = s->getAxis() != NO_AXIS;
            // The following test could be expressed more succinctly with XOR,
            // but is arguably clearer when written out
            if ((wantAxis && isAxis) || (!wantAxis && !isAxis)) {
                show_setting(s->getGrblName(), s->getCompatibleValue(), NULL, out);
            }
        }
    }
}
Error report_normal_settings(const char* value, WebUI::AuthenticationLevel auth_level, WebUI::ESPResponseStream* out) {
    show_grbl_settings(out, GRBL, false);  // GRBL non-axis settings
    show_grbl_settings(out, GRBL, true);   // GRBL axis settings
    return Error::Ok;
}
Error report_extended_settings(const char* value, WebUI::AuthenticationLevel auth_level, WebUI::ESPResponseStream* out) {
    show_grbl_settings(out, GRBL, false);      // GRBL non-axis settings
    show_grbl_settings(out, EXTENDED, false);  // Extended non-axis settings
    show_grbl_settings(out, GRBL, true);       // GRBL axis settings
    show_grbl_settings(out, EXTENDED, true);   // Extended axis settings
    return Error::Ok;
}
Error list_grbl_names(const char* value, WebUI::AuthenticationLevel auth_level, WebUI::ESPResponseStream* out) {
    for (Setting* s = Setting::List; s; s = s->next()) {
        const char* gn = s->getGrblName();
        if (gn) {
            grbl_sendf(out->client(), "$%s => $%s\r\n", gn, s->getName());
        }
    }
    return Error::Ok;
}
Error list_settings(const char* value, WebUI::AuthenticationLevel auth_level, WebUI::ESPResponseStream* out) {
    for (Setting* s = Setting::List; s; s = s->next()) {
        const char* displayValue = auth_failed(s, value, auth_level) ? "<Authentication required>" : s->getStringValue();
        show_setting(s->getName(), displayValue, NULL, out);
    }
    return Error::Ok;
}
Error list_changed_settings(const char* value, WebUI::AuthenticationLevel auth_level, WebUI::ESPResponseStream* out) {
    for (Setting* s = Setting::List; s; s = s->next()) {
        const char* value  = s->getStringValue();
        const char* defval = s->getDefaultString();
        if (!auth_failed(s, value, auth_level) && strcmp(value, defval)) {
            String message = "(Default=";
            message += defval;
            message += ")";
            show_setting(s->getName(), value, message.c_str(), out);
        }
    }
    grbl_sendf(out->client(), "(Passwords not shown)\r\n");
    return Error::Ok;
}
Error list_commands(const char* value, WebUI::AuthenticationLevel auth_level, WebUI::ESPResponseStream* out) {
    for (Command* cp = Command::List; cp; cp = cp->next()) {
        const char* name    = cp->getName();
        const char* oldName = cp->getGrblName();
        if (oldName) {
            grbl_sendf(out->client(), "$%s or $%s", name, oldName);
        } else {
            grbl_sendf(out->client(), "$%s", name);
        }
        const char* description = cp->getDescription();
        if (description) {
            grbl_sendf(out->client(), " =%s", description);
        }
        grbl_sendf(out->client(), "\r\n");
    }
    return Error::Ok;
}
Error toggle_check_mode(const char* value, WebUI::AuthenticationLevel auth_level, WebUI::ESPResponseStream* out) {
    // Perform reset when toggling off. Check g-code mode should only work if Grbl
    // is idle and ready, regardless of alarm locks. This is mainly to keep things
    // simple and consistent.
    if (sys.state == State::CheckMode) {
        mc_reset();
        report_feedback_message(Message::Disabled);
    } else {
        if (sys.state != State::Idle) {
            return Error::IdleError;  // Requires no alarm mode.
        }
        sys.state = State::CheckMode;
        report_feedback_message(Message::Enabled);
    }
    return Error::Ok;
}
Error disable_alarm_lock(const char* value, WebUI::AuthenticationLevel auth_level, WebUI::ESPResponseStream* out) {
    if (sys.state == State::Alarm) {
        // Block if safety door is ajar.
        if (system_check_safety_door_ajar()) {
            return Error::CheckDoor;
        }
        report_feedback_message(Message::AlarmUnlock);
        sys.state = State::Idle;
        // Don't run startup script. Prevents stored moves in startup from causing accidents.
    }  // Otherwise, no effect.
    return Error::Ok;
}
Error report_ngc(const char* value, WebUI::AuthenticationLevel auth_level, WebUI::ESPResponseStream* out) {
    report_ngc_parameters(out->client());
    return Error::Ok;
}
Error home(int cycle) {
    if (homing_enable->get() == false) {
        return Error::SettingDisabled;
    }
    if (system_check_safety_door_ajar()) {
        return Error::CheckDoor;  // Block if safety door is ajar.
    }
    sys.state = State::Homing;  // Set system state variable
#ifdef USE_I2S_STEPS
    stepper_id_t save_stepper = current_stepper;
    if (save_stepper == ST_I2S_STREAM) {
        stepper_switch(ST_I2S_STATIC);
    }

    mc_homing_cycle(cycle);

    if (save_stepper == ST_I2S_STREAM && current_stepper != ST_I2S_STREAM) {
        stepper_switch(ST_I2S_STREAM);
    }
#else
    mc_homing_cycle(cycle);
#endif
    if (!sys.abort) {             // Execute startup scripts after successful homing.
        sys.state = State::Idle;  // Set to IDLE when complete.
        st_go_idle();             // Set steppers to the settings idle state before returning.
        if (cycle == HOMING_CYCLE_ALL) {
            char line[128];
            system_execute_startup(line);
        }
    }
    return Error::Ok;
}
Error home_all(const char* value, WebUI::AuthenticationLevel auth_level, WebUI::ESPResponseStream* out) {
    return home(HOMING_CYCLE_ALL);
}
Error home_x(const char* value, WebUI::AuthenticationLevel auth_level, WebUI::ESPResponseStream* out) {
    return home(bit(X_AXIS));
}
Error home_y(const char* value, WebUI::AuthenticationLevel auth_level, WebUI::ESPResponseStream* out) {
    return home(bit(Y_AXIS));
}
Error home_z(const char* value, WebUI::AuthenticationLevel auth_level, WebUI::ESPResponseStream* out) {
    return home(bit(Z_AXIS));
}
Error home_a(const char* value, WebUI::AuthenticationLevel auth_level, WebUI::ESPResponseStream* out) {
    return home(bit(A_AXIS));
}
Error home_b(const char* value, WebUI::AuthenticationLevel auth_level, WebUI::ESPResponseStream* out) {
    return home(bit(B_AXIS));
}
Error home_c(const char* value, WebUI::AuthenticationLevel auth_level, WebUI::ESPResponseStream* out) {
    return home(bit(C_AXIS));
}
Error sleep_grbl(const char* value, WebUI::AuthenticationLevel auth_level, WebUI::ESPResponseStream* out) {
    sys_rt_exec_state.bit.sleep = true;
    return Error::Ok;
}
Error get_report_build_info(const char* value, WebUI::AuthenticationLevel auth_level, WebUI::ESPResponseStream* out) {
    if (!value) {
        report_build_info(build_info->get(), out->client());
        return Error::Ok;
    }
    return Error::InvalidStatement;
}
Error report_startup_lines(const char* value, WebUI::AuthenticationLevel auth_level, WebUI::ESPResponseStream* out) {
    report_startup_line(0, startup_line_0->get(), out->client());
    report_startup_line(1, startup_line_1->get(), out->client());
    return Error::Ok;
}

std::map<const char*, uint8_t, cmp_str> restoreCommands = {
#ifdef ENABLE_RESTORE_DEFAULT_SETTINGS
    { "$", SettingsRestore::Defaults },   { "settings", SettingsRestore::Defaults },
#endif
#ifdef ENABLE_RESTORE_CLEAR_PARAMETERS
    { "#", SettingsRestore::Parameters }, { "gcode", SettingsRestore::Parameters },
#endif
#ifdef ENABLE_RESTORE_WIPE_ALL
    { "*", SettingsRestore::All },        { "all", SettingsRestore::All },
#endif
    { "@", SettingsRestore::Wifi },       { "wifi", SettingsRestore::Wifi },
};
Error restore_settings(const char* value, WebUI::AuthenticationLevel auth_level, WebUI::ESPResponseStream* out) {
    if (!value) {
        return Error::InvalidStatement;
    }
    auto it = restoreCommands.find(value);
    if (it == restoreCommands.end()) {
        return Error::InvalidStatement;
    }
    settings_restore(it->second);
    return Error::Ok;
}

Error showState(const char* value, WebUI::AuthenticationLevel auth_level, WebUI::ESPResponseStream* out) {
    grbl_sendf(out->client(), "State 0x%x\r\n", sys.state);
    return Error::Ok;
}
Error doJog(const char* value, WebUI::AuthenticationLevel auth_level, WebUI::ESPResponseStream* out) {
    // For jogging, you must give gc_execute_line() a line that
    // begins with $J=.  There are several ways we can get here,
    // including  $J, $J=xxx, [J]xxx.  For any form other than
    // $J without =, we reconstruct a $J= line for gc_execute_line().
    if (!value) {
        return Error::InvalidStatement;
    }
    char jogLine[LINE_BUFFER_SIZE];
    strcpy(jogLine, "$J=");
    strcat(jogLine, value);
    return gc_execute_line(jogLine, out->client());
}

const char* alarmString(ExecAlarm alarmNumber) {
    auto it = AlarmNames.find(alarmNumber);
    return it == AlarmNames.end() ? NULL : it->second;
}

Error listAlarms(const char* value, WebUI::AuthenticationLevel auth_level, WebUI::ESPResponseStream* out) {
    if (value) {
        char*   endptr      = NULL;
        uint8_t alarmNumber = strtol(value, &endptr, 10);
        if (*endptr) {
            grbl_sendf(out->client(), "Malformed alarm number: %s\r\n", value);
            return Error::InvalidValue;
        }
        const char* alarmName = alarmString(static_cast<ExecAlarm>(alarmNumber));
        if (alarmName) {
            grbl_sendf(out->client(), "%d: %s\r\n", alarmNumber, alarmName);
            return Error::Ok;
        } else {
            grbl_sendf(out->client(), "Unknown alarm number: %d\r\n", alarmNumber);
            return Error::InvalidValue;
        }
    }

    for (auto it = AlarmNames.begin(); it != AlarmNames.end(); it++) {
        grbl_sendf(out->client(), "%d: %s\r\n", it->first, it->second);
    }
    return Error::Ok;
}

const char* errorString(Error errorNumber) {
    auto it = ErrorNames.find(errorNumber);
    return it == ErrorNames.end() ? NULL : it->second;
}

Error listErrors(const char* value, WebUI::AuthenticationLevel auth_level, WebUI::ESPResponseStream* out) {
    if (value) {
        char*   endptr      = NULL;
        uint8_t errorNumber = strtol(value, &endptr, 10);
        if (*endptr) {
            grbl_sendf(out->client(), "Malformed error number: %s\r\n", value);
            return Error::InvalidValue;
        }
        const char* errorName = errorString(static_cast<Error>(errorNumber));
        if (errorName) {
            grbl_sendf(out->client(), "%d: %s\r\n", errorNumber, errorName);
            return Error::Ok;
        } else {
            grbl_sendf(out->client(), "Unknown error number: %d\r\n", errorNumber);
            return Error::InvalidValue;
        }
    }

    for (auto it = ErrorNames.begin(); it != ErrorNames.end(); it++) {
        grbl_sendf(out->client(), "%d: %s\r\n", it->first, it->second);
    }
    return Error::Ok;
}

Error motor_disable(const char* value, WebUI::AuthenticationLevel auth_level, WebUI::ESPResponseStream* out) {
    char* s;
    if (value == NULL) {
        value = "\0";
    }

    s = strdup(value);
    s = trim(s);

    int32_t convertedValue;
    char*   endptr;
    if (*s == '\0') {
        convertedValue = 255;  // all axes
    } else {
        convertedValue = strtol(s, &endptr, 10);
        if (endptr == s || *endptr != '\0') {
            // Try to convert as an axis list
            convertedValue = 0;
            auto axisNames = String("XYZABC");
            while (*s) {
                int index = axisNames.indexOf(toupper(*s++));
                if (index < 0) {
                    return Error::BadNumberFormat;
                }
                convertedValue |= bit(index);
            }
        }
    }
    motors_set_disable(true, convertedValue);
    return Error::Ok;
}

static bool anyState() {
    return false;
}
static bool idleOrJog() {
    return sys.state != State::Idle && sys.state != State::Jog;
}
bool idleOrAlarm() {
    return sys.state != State::Idle && sys.state != State::Alarm;
}
static bool notCycleOrHold() {
    return sys.state == State::Cycle && sys.state == State::Hold;
}

// Commands use the same syntax as Settings, but instead of setting or
// displaying a persistent value, a command causes some action to occur.
// That action could be anything, from displaying a run-time parameter
// to performing some system state change.  Each command is responsible
// for decoding its own value string, if it needs one.
void make_grbl_commands() {
    new GrblCommand("", "Help", show_grbl_help, anyState);
    new GrblCommand("T", "State", showState, anyState);
    new GrblCommand("J", "Jog", doJog, idleOrJog);

    new GrblCommand("$", "GrblSettings/List", report_normal_settings, notCycleOrHold);
    new GrblCommand("+", "ExtendedSettings/List", report_extended_settings, notCycleOrHold);
    new GrblCommand("L", "GrblNames/List", list_grbl_names, notCycleOrHold);
    new GrblCommand("S", "Settings/List", list_settings, notCycleOrHold);
    new GrblCommand("SC", "Settings/ListChanged", list_changed_settings, notCycleOrHold);
    new GrblCommand("CMD", "Commands/List", list_commands, notCycleOrHold);
    new GrblCommand("A", "Alarms/List", listAlarms, anyState);
    new GrblCommand("E", "Errors/List", listErrors, anyState);
    new GrblCommand("G", "GCode/Modes", report_gcode, anyState);
    new GrblCommand("C", "GCode/Check", toggle_check_mode, anyState);
    new GrblCommand("X", "Alarm/Disable", disable_alarm_lock, anyState);
    new GrblCommand("NVX", "Settings/Erase", Setting::eraseNVS, idleOrAlarm, WA);
    new GrblCommand("V", "Settings/Stats", Setting::report_nvs_stats, idleOrAlarm);
    new GrblCommand("#", "GCode/Offsets", report_ngc, idleOrAlarm);
    new GrblCommand("H", "Home", home_all, idleOrAlarm);
    new GrblCommand("MD", "Motor/Disable", motor_disable, idleOrAlarm);

#ifdef HOMING_SINGLE_AXIS_COMMANDS
    new GrblCommand("HX", "Home/X", home_x, idleOrAlarm);
    new GrblCommand("HY", "Home/Y", home_y, idleOrAlarm);
    new GrblCommand("HZ", "Home/Z", home_z, idleOrAlarm);
    new GrblCommand("HA", "Home/A", home_a, idleOrAlarm);
    new GrblCommand("HB", "Home/B", home_b, idleOrAlarm);
    new GrblCommand("HC", "Home/C", home_c, idleOrAlarm);
#endif
    new GrblCommand("SLP", "System/Sleep", sleep_grbl, idleOrAlarm);
    new GrblCommand("I", "Build/Info", get_report_build_info, idleOrAlarm);
    new GrblCommand("N", "GCode/StartupLines", report_startup_lines, idleOrAlarm);
    new GrblCommand("RST", "Settings/Restore", restore_settings, idleOrAlarm, WA);
};

// normalize_key puts a key string into canonical form -
// without whitespace.
// start points to a null-terminated string.
// Returns the first substring that does not contain whitespace.
// Case is unchanged because comparisons are case-insensitive.
char* normalize_key(char* start) {
    char c;

    // In the usual case, this loop will exit on the very first test,
    // because the first character is likely to be non-white.
    // Null ('\0') is not considered to be a space character.
    while (isspace(c = *start) && c != '\0') {
        ++start;
    }

    // start now points to either a printable character or end of string
    if (c == '\0') {
        return start;
    }

    // Having found the beginning of the printable string,
    // we now scan forward until we find a space character.
    char* end;
    for (end = start; (c = *end) != '\0' && !isspace(c); end++) {}

    // end now points to either a whitespace character of end of string
    // In either case it is okay to place a null there
    *end = '\0';

    return start;
}

// This is the handler for all forms of settings commands,
// $..= and [..], with and without a value.
Error do_command_or_setting(const char* key, char* value, WebUI::AuthenticationLevel auth_level, WebUI::ESPResponseStream* out) {
    // If value is NULL, it means that there was no value string, i.e.
    // $key without =, or [key] with nothing following.
    // If value is not NULL, but the string is empty, that is the form
    // $key= with nothing following the = .  It is important to distinguish
    // those cases so that you can say "$N0=" to clear a startup line.

    // First search the settings list by text name.  If found, set a new
    // value if one is given, otherwise display the current value
    for (Setting* s = Setting::List; s; s = s->next()) {
        if (strcasecmp(s->getName(), key) == 0) {
            if (auth_failed(s, value, auth_level)) {
                return Error::AuthenticationFailed;
            }
            if (value) {
                return s->setStringValue(value);
            } else {
                show_setting(s->getName(), s->getStringValue(), NULL, out);
                return Error::Ok;
            }
        }
    }

    // Then search the setting list by compatible name.  If found, set a new
    // value if one is given, otherwise display the current value in compatible mode
    for (Setting* s = Setting::List; s; s = s->next()) {
        if (s->getGrblName() && strcasecmp(s->getGrblName(), key) == 0) {
            if (auth_failed(s, value, auth_level)) {
                return Error::AuthenticationFailed;
            }
            if (value) {
                return s->setStringValue(value);
            } else {
                show_setting(s->getGrblName(), s->getCompatibleValue(), NULL, out);
                return Error::Ok;
            }
        }
    }
    // If we did not find a setting, look for a command.  Commands
    // handle values internally; you cannot determine whether to set
    // or display solely based on the presence of a value.
    for (Command* cp = Command::List; cp; cp = cp->next()) {
        if ((strcasecmp(cp->getName(), key) == 0) || (cp->getGrblName() && strcasecmp(cp->getGrblName(), key) == 0)) {
            if (auth_failed(cp, value, auth_level)) {
                return Error::AuthenticationFailed;
            }
            return cp->action(value, auth_level, out);
        }
    }

    // If we did not find an exact match and there is no value,
    // indicating a display operation, we allow partial matches
    // and display every possibility.  This only applies to the
    // text form of the name, not to the nnn and ESPnnn forms.
    Error retval = Error::InvalidStatement;
    if (!value) {
        auto lcKey = String(key);
        // We allow the key string to begin with *, which we remove.
        // This lets us look at X axis settings with $*x.
        // $x by itself is the disable alarm lock command
        if (lcKey.startsWith("*")) {
            lcKey.remove(0, 1);
        }
        lcKey.toLowerCase();
        bool found = false;
        for (Setting* s = Setting::List; s; s = s->next()) {
            auto lcTest = String(s->getName());
            lcTest.toLowerCase();

            if (lcTest.indexOf(lcKey) >= 0) {
                const char* displayValue = auth_failed(s, value, auth_level) ? "<Authentication required>" : s->getStringValue();
                show_setting(s->getName(), displayValue, NULL, out);
                found = true;
            }
        }
        if (found) {
            return Error::Ok;
        }
    }
    return Error::InvalidStatement;
}

Error system_execute_line(char* line, WebUI::ESPResponseStream* out, WebUI::AuthenticationLevel auth_level) {
    remove_password(line, auth_level);

    char* value;
    if (*line++ == '[') {  // [ESPxxx] form
        value = strrchr(line, ']');
        if (!value) {
            // Missing ] is an error in this form
            return Error::InvalidStatement;
        }
        // ']' was found; replace it with null and set value to the rest of the line.
        *value++ = '\0';
        // If the rest of the line is empty, replace value with NULL.
        if (*value == '\0') {
            value = NULL;
        }
    } else {
        // $xxx form
        value = strchr(line, '=');
        if (value) {
            // $xxx=yyy form.
            *value++ = '\0';
        }
    }

    char* key = normalize_key(line);

    // At this point there are three possibilities for value
    // NULL - $xxx without =
    // NULL - [ESPxxx] with nothing after ]
    // empty string - $xxx= with nothing after
    // non-empty string - [ESPxxx]yyy or $xxx=yyy
    return do_command_or_setting(key, value, auth_level, out);
}

Error system_execute_line(char* line, uint8_t client, WebUI::AuthenticationLevel auth_level) {
    WebUI::ESPResponseStream stream(client, true);
    return system_execute_line(line, &stream, auth_level);
}

void system_execute_startup(char* line) {
    Error status_code;
    char  gcline[256];
    strncpy(gcline, startup_line_0->get(), 255);
    if (*gcline) {
        status_code = gc_execute_line(gcline, CLIENT_SERIAL);
        report_execute_startup_message(gcline, status_code, CLIENT_SERIAL);
    }
    strncpy(gcline, startup_line_1->get(), 255);
    if (*gcline) {
        status_code = gc_execute_line(gcline, CLIENT_SERIAL);
        report_execute_startup_message(gcline, status_code, CLIENT_SERIAL);
    }
}
