scottbez1/Grbl_Esp32/Grbl_Esp32/src/GCode.cpp

/*
  GCode.cpp - rs274/ngc parser.
  Part of Grbl

  Copyright (c) 2011-2016 Sungeun K. Jeon for Gnea Research LLC
  Copyright (c) 2009-2011 Simen Svale Skogsrud

	2018 -	Bart Dring This file was modifed for use on the ESP32
					CPU. Do not use this with Grbl for atMega328P

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
  You should have received a copy of the GNU General Public License
  along with Grbl.  If not, see <http://www.gnu.org/licenses/>.
*/

#include "Grbl.h"

// Allow iteration over CoordIndex values
CoordIndex& operator++(CoordIndex& i) {
    i = static_cast<CoordIndex>(static_cast<uint8_t>(i) + 1);
    return i;
}

// NOTE: Max line number is defined by the g-code standard to be 99999. It seems to be an
// arbitrary value, and some GUIs may require more. So we increased it based on a max safe
// value when converting a float (7.2 digit precision)s to an integer.
static const int32_t MaxLineNumber = 10000000;
static const uint8_t MaxToolNumber = 255;  // Limited by max unsigned 8-bit value

// Declare gc extern struct
parser_state_t gc_state;
parser_block_t gc_block;

#define FAIL(status) return (status);

void gc_init() {
    // Reset parser state:
    memset(&gc_state, 0, sizeof(parser_state_t));
    // Load default G54 coordinate system.
    gc_state.modal.coord_select = CoordIndex::G54;
    coords[gc_state.modal.coord_select]->get(gc_state.coord_system);
}

// Sets g-code parser position in mm. Input in steps. Called by the system abort and hard
// limit pull-off routines.
void gc_sync_position() {
    system_convert_array_steps_to_mpos(gc_state.position, sys_position);
}

// Edit GCode line in-place, removing whitespace and comments and
// converting to uppercase
void collapseGCode(char* line) {
    // parenPtr, if non-NULL, is the address of the character after (
    char* parenPtr = NULL;
    // outPtr is the address where newly-processed characters will be placed.
    // outPtr is alway less than or equal to inPtr.
    char* outPtr = line;
    char  c;
    for (char* inPtr = line; (c = *inPtr) != '\0'; inPtr++) {
        if (isspace(c)) {
            continue;
        }
        switch (c) {
            case ')':
                if (parenPtr) {
                    // Terminate comment by replacing ) with NUL
                    *inPtr = '\0';
                    report_gcode_comment(parenPtr);
                    parenPtr = NULL;
                }
                // Strip out ) that does not follow a (
                break;
            case '(':
                // Start the comment at the character after (
                parenPtr = inPtr + 1;
                break;
            case ';':
                // NOTE: ';' comment to EOL is a LinuxCNC definition. Not NIST.
#ifdef REPORT_SEMICOLON_COMMENTS
                report_gcode_comment(inPtr + 1);
#endif
                *outPtr = '\0';
                return;
            case '%':
                // TODO: Install '%' feature
                // Program start-end percent sign NOT SUPPORTED.
                // NOTE: This maybe installed to tell Grbl when a program is running vs manual input,
                // where, during a program, the system auto-cycle start will continue to execute
                // everything until the next '%' sign. This will help fix resuming issues with certain
                // functions that empty the planner buffer to execute its task on-time.
                break;
            case '\r':
                // In case one sneaks in
                break;
            default:
                if (!parenPtr) {
                    *outPtr++ = toupper(c);  // make upper case
                }
        }
    }
    // On loop exit, *inPtr is '\0'
    if (parenPtr) {
        // Handle unterminated ( comments
        report_gcode_comment(parenPtr);
    }
    *outPtr = '\0';
}

// Executes one line of NUL-terminated G-Code.
// The line may contain whitespace and comments, which are first removed,
// and lower case characters, which are converted to upper case.
// In this function, all units and positions are converted and
// exported to grbl's internal functions in terms of (mm, mm/min) and absolute machine
// coordinates, respectively.
Error gc_execute_line(char* line, uint8_t client) {
    // Step 0 - remove whitespace and comments and convert to upper case
    collapseGCode(line);
#ifdef REPORT_ECHO_LINE_RECEIVED
    report_echo_line_received(line, client);
#endif

    /* -------------------------------------------------------------------------------------
       STEP 1: Initialize parser block struct and copy current g-code state modes. The parser
       updates these modes and commands as the block line is parser and will only be used and
       executed after successful error-checking. The parser block struct also contains a block
       values struct, word tracking variables, and a non-modal commands tracker for the new
       block. This struct contains all of the necessary information to execute the block. */
    memset(&gc_block, 0, sizeof(parser_block_t));                  // Initialize the parser block struct.
    memcpy(&gc_block.modal, &gc_state.modal, sizeof(gc_modal_t));  // Copy current modes
    AxisCommand axis_command = AxisCommand::None;
    uint8_t     axis_0, axis_1, axis_linear;
    CoordIndex  coord_select = CoordIndex::G54;  // Tracks G10 P coordinate selection for execution
    // Initialize bitflag tracking variables for axis indices compatible operations.
    uint8_t axis_words = 0;  // XYZ tracking
    uint8_t ijk_words  = 0;  // IJK tracking
    // Initialize command and value words and parser flags variables.
    uint32_t command_words   = 0;  // Tracks G and M command words. Also used for modal group violations.
    uint32_t value_words     = 0;  // Tracks value words.
    uint8_t  gc_parser_flags = GCParserNone;
    auto     n_axis          = number_axis->get();
    float    coord_data[MAX_N_AXIS];  // Used by WCO-related commands
    uint8_t  pValue;                  // Integer value of P word

    // Determine if the line is a jogging motion or a normal g-code block.
    if (line[0] == '$') {  // NOTE: `$J=` already parsed when passed to this function.
        // Set G1 and G94 enforced modes to ensure accurate error checks.
        gc_parser_flags |= GCParserJogMotion;
        gc_block.modal.motion    = Motion::Linear;
        gc_block.modal.feed_rate = FeedRate::UnitsPerMin;
#ifdef USE_LINE_NUMBERS
        gc_block.values.n = JOG_LINE_NUMBER;  // Initialize default line number reported during jog.
#endif
    }

    /* -------------------------------------------------------------------------------------
       STEP 2: Import all g-code words in the block line. A g-code word is a letter followed by
       a number, which can either be a 'G'/'M' command or sets/assigns a command value. Also,
       perform initial error-checks for command word modal group violations, for any repeated
       words, and for negative values set for the value words F, N, P, T, and S. */
    ModalGroup mg_word_bit;  // Bit-value for assigning tracking variables
    uint32_t   bitmask = 0;
    uint8_t    char_counter;
    char       letter;
    float      value;
    uint8_t    int_value = 0;
    uint16_t   mantissa  = 0;
    if (gc_parser_flags & GCParserJogMotion) {
        char_counter = 3;  // Start parsing after `$J=`
    } else {
        char_counter = 0;
    }
    while (line[char_counter] != 0) {  // Loop until no more g-code words in line.
        // Import the next g-code word, expecting a letter followed by a value. Otherwise, error out.
        letter = line[char_counter];
        if ((letter < 'A') || (letter > 'Z')) {
            FAIL(Error::ExpectedCommandLetter);  // [Expected word letter]
        }
        char_counter++;
        if (!read_float(line, &char_counter, &value)) {
            FAIL(Error::BadNumberFormat);  // [Expected word value]
        }
        // Convert values to smaller uint8 significand and mantissa values for parsing this word.
        // NOTE: Mantissa is multiplied by 100 to catch non-integer command values. This is more
        // accurate than the NIST gcode requirement of x10 when used for commands, but not quite
        // accurate enough for value words that require integers to within 0.0001. This should be
        // a good enough compromise and catch most all non-integer errors. To make it compliant,
        // we would simply need to change the mantissa to int16, but this add compiled flash space.
        // Maybe update this later.
        int_value = trunc(value);
        mantissa  = round(100 * (value - int_value));  // Compute mantissa for Gxx.x commands.
        // NOTE: Rounding must be used to catch small floating point errors.
        // Check if the g-code word is supported or errors due to modal group violations or has
        // been repeated in the g-code block. If ok, update the command or record its value.
        switch (letter) {
            /* 'G' and 'M' Command Words: Parse commands and check for modal group violations.
           NOTE: Modal group numbers are defined in Table 4 of NIST RS274-NGC v3, pg.20 */
            case 'G':
                // Determine 'G' command and its modal group
                switch (int_value) {
                    // Modal Group G0 - non-modal actions
                    case 10:
                        gc_block.non_modal_command = NonModal::SetCoordinateData;
                        if (mantissa == 0) {
                            if (axis_command != AxisCommand::None) {
                                FAIL(Error::GcodeAxisCommandConflict);  // [Axis word/command conflict]
                            }
                            axis_command = AxisCommand::NonModal;
                        }
                        mg_word_bit = ModalGroup::MG0;
                        break;

                    case 28:
                        gc_block.non_modal_command = mantissa ? NonModal::SetHome0 : NonModal::GoHome0;
                        goto check_mantissa;
                    case 30:
                        gc_block.non_modal_command = mantissa ? NonModal::SetHome1 : NonModal::GoHome1;
                        goto check_mantissa;
                    case 92:
                        gc_block.non_modal_command = mantissa ? NonModal::ResetCoordinateOffset : NonModal::SetCoordinateOffset;
                    check_mantissa:
                        // Check for G10/28/30/92 being called with G0/1/2/3/38 on same block.
                        // * G43.1 is also an axis command but is not explicitly defined this way.
                        switch (mantissa) {
                            case 0:  // Ignore G28.1, G30.1, and G92.1
                                if (axis_command != AxisCommand::None) {
                                    FAIL(Error::GcodeAxisCommandConflict);  // [Axis word/command conflict]
                                }
                                axis_command = AxisCommand::NonModal;
                                break;
                            case 10:
                                mantissa = 0;  // Set to zero to indicate valid non-integer G command.
                                break;
                            default:
                                FAIL(Error::GcodeUnsupportedCommand);
                                // not reached
                                break;
                        }
                        mg_word_bit = ModalGroup::MG0;
                        break;
                    case 4:
                        gc_block.non_modal_command = NonModal::Dwell;
                        mg_word_bit                = ModalGroup::MG0;
                        break;
                    case 53:
                        gc_block.non_modal_command = NonModal::AbsoluteOverride;
                        mg_word_bit                = ModalGroup::MG0;
                        break;

                    // Modal Group G1 - motion commands
                    case 0:  // G0 - linear rapid traverse
                        axis_command          = AxisCommand::MotionMode;
                        gc_block.modal.motion = Motion::Seek;
                        mg_word_bit           = ModalGroup::MG1;
                        break;
                    case 1:  // G1 - linear feedrate move
                        axis_command          = AxisCommand::MotionMode;
                        gc_block.modal.motion = Motion::Linear;
                        mg_word_bit           = ModalGroup::MG1;
                        break;
                    case 2:  // G2 - clockwise arc
                        axis_command          = AxisCommand::MotionMode;
                        gc_block.modal.motion = Motion::CwArc;
                        mg_word_bit           = ModalGroup::MG1;
                        break;
                    case 3:  // G3 - counterclockwise arc
                        axis_command          = AxisCommand::MotionMode;
                        gc_block.modal.motion = Motion::CcwArc;
                        mg_word_bit           = ModalGroup::MG1;
                        break;
                    case 38:  // G38 - probe
                        //only allow G38 "Probe" commands if a probe pin is defined.
                        if (PROBE_PIN == UNDEFINED_PIN) {
                            grbl_msg_sendf(CLIENT_SERIAL, MsgLevel::Info, "No probe pin defined");
                            FAIL(Error::GcodeUnsupportedCommand);  // [Unsupported G command]
                        }
                        // Check for G0/1/2/3/38 being called with G10/28/30/92 on same block.
                        // * G43.1 is also an axis command but is not explicitly defined this way.
                        if (axis_command != AxisCommand::None) {
                            FAIL(Error::GcodeAxisCommandConflict);  // [Axis word/command conflict]
                        }
                        axis_command = AxisCommand::MotionMode;
                        switch (mantissa) {
                            case 20:
                                gc_block.modal.motion = Motion::ProbeToward;
                                break;
                            case 30:
                                gc_block.modal.motion = Motion::ProbeTowardNoError;
                                break;
                            case 40:
                                gc_block.modal.motion = Motion::ProbeAway;
                                break;
                            case 50:
                                gc_block.modal.motion = Motion::ProbeAway;
                                break;
                            default:
                                FAIL(Error::GcodeUnsupportedCommand);
                                break;  // [Unsupported G38.x command]
                        }
                        mantissa    = 0;  // Set to zero to indicate valid non-integer G command.
                        mg_word_bit = ModalGroup::MG1;
                        break;

                    case 80:  // G80 - cancel canned cycle
                        gc_block.modal.motion = Motion::None;
                        mg_word_bit           = ModalGroup::MG1;
                        break;
                    case 17:
                        gc_block.modal.plane_select = Plane::XY;
                        mg_word_bit                 = ModalGroup::MG2;
                        break;
                    case 18:
                        gc_block.modal.plane_select = Plane::ZX;
                        mg_word_bit                 = ModalGroup::MG2;
                        break;
                    case 19:
                        gc_block.modal.plane_select = Plane::YZ;
                        mg_word_bit                 = ModalGroup::MG2;
                        break;
                    case 90:
                        switch (mantissa) {
                            case 0:
                                gc_block.modal.distance = Distance::Absolute;
                                mg_word_bit             = ModalGroup::MG3;
                                break;
                            case 10:
                                FAIL(Error::GcodeUnsupportedCommand);  // [G90.1 not supported]
                                // mg_word_bit = ModalGroup::MG4;
                                // gc_block.modal.distance_arc = ArcDistance::Absolute;
                                break;
                            default:
                                FAIL(Error::GcodeUnsupportedCommand);
                                break;
                        }
                        break;
                    case 91:
                        switch (mantissa) {
                            case 0:
                                gc_block.modal.distance = Distance::Incremental;
                                mg_word_bit             = ModalGroup::MG3;
                                break;
                            case 10:
                                mantissa = 0;  // Set to zero to indicate valid non-integer G command.
                                // Arc incremental mode is the default and only supported mode
                                // gc_block.modal.distance_arc = ArcDistance::Incremental;
                                mg_word_bit = ModalGroup::MG4;
                                break;
                            default:
                                FAIL(Error::GcodeUnsupportedCommand);
                                break;
                        }
                        break;
                    case 93:
                        gc_block.modal.feed_rate = FeedRate::InverseTime;
                        mg_word_bit              = ModalGroup::MG5;
                        break;
                    case 94:
                        gc_block.modal.feed_rate = FeedRate::UnitsPerMin;
                        mg_word_bit              = ModalGroup::MG5;
                        break;
                    case 20:
                        gc_block.modal.units = Units::Inches;
                        mg_word_bit          = ModalGroup::MG6;
                        break;
                    case 21:
                        gc_block.modal.units = Units::Mm;
                        mg_word_bit          = ModalGroup::MG6;
                        break;
                    case 40:
                        // NOTE: Not required since cutter radius compensation is always disabled. Only here
                        // to support G40 commands that often appear in g-code program headers to setup defaults.
                        // gc_block.modal.cutter_comp = CutterCompensation::Disable; // G40
                        mg_word_bit = ModalGroup::MG7;
                        break;
                    case 43:
                    case 49:
                        // NOTE: The NIST g-code standard vaguely states that when a tool length offset is changed,
                        // there cannot be any axis motion or coordinate offsets updated. Meaning G43, G43.1, and G49
                        // all are explicit axis commands, regardless if they require axis words or not.
                        if (axis_command != AxisCommand::None) {
                            FAIL(Error::GcodeAxisCommandConflict);
                        }
                        // [Axis word/command conflict] }
                        axis_command = AxisCommand::ToolLengthOffset;
                        if (int_value == 49) {  // G49
                            gc_block.modal.tool_length = ToolLengthOffset::Cancel;
                        } else if (mantissa == 10) {  // G43.1
                            gc_block.modal.tool_length = ToolLengthOffset::EnableDynamic;
                        } else {
                            FAIL(Error::GcodeUnsupportedCommand);  // [Unsupported G43.x command]
                        }
                        mantissa    = 0;  // Set to zero to indicate valid non-integer G command.
                        mg_word_bit = ModalGroup::MG8;
                        break;
                    case 54:
                        gc_block.modal.coord_select = CoordIndex::G54;
                        mg_word_bit                 = ModalGroup::MG12;
                        break;
                    case 55:
                        gc_block.modal.coord_select = CoordIndex::G55;
                        mg_word_bit                 = ModalGroup::MG12;
                        break;
                    case 56:
                        gc_block.modal.coord_select = CoordIndex::G56;
                        mg_word_bit                 = ModalGroup::MG12;
                        break;
                    case 57:
                        gc_block.modal.coord_select = CoordIndex::G57;
                        mg_word_bit                 = ModalGroup::MG12;
                        break;
                    case 58:
                        gc_block.modal.coord_select = CoordIndex::G58;
                        mg_word_bit                 = ModalGroup::MG12;
                        break;
                    case 59:
                        gc_block.modal.coord_select = CoordIndex::G59;
                        mg_word_bit                 = ModalGroup::MG12;
                        break;
                        // NOTE: G59.x are not supported.
                    case 61:
                        if (mantissa != 0) {
                            FAIL(Error::GcodeUnsupportedCommand);  // [G61.1 not supported]
                        }
                        // gc_block.modal.control = ControlMode::ExactPath; // G61
                        mg_word_bit = ModalGroup::MG13;
                        break;
                    default:
                        FAIL(Error::GcodeUnsupportedCommand);  // [Unsupported G command]
                }
                if (mantissa > 0) {
                    FAIL(Error::GcodeCommandValueNotInteger);  // [Unsupported or invalid Gxx.x command]
                }
                // Check for more than one command per modal group violations in the current block
                // NOTE: Variable 'mg_word_bit' is always assigned, if the command is valid.
                bitmask = bit(mg_word_bit);
                if (bit_istrue(command_words, bitmask)) {
                    FAIL(Error::GcodeModalGroupViolation);
                }
                command_words |= bitmask;
                break;
            case 'M':
                // Determine 'M' command and its modal group
                if (mantissa > 0) {
                    FAIL(Error::GcodeCommandValueNotInteger);  // [No Mxx.x commands]
                }
                switch (int_value) {
                    case 0:
                        // M0 - Pause
                        gc_block.modal.program_flow = ProgramFlow::Paused;
                        mg_word_bit                 = ModalGroup::MM4;
                        break;
                    case 1:
                        // M1 - Optional Stop not supported
                        mg_word_bit = ModalGroup::MM4;
                        break;
                    case 2:
                        // M2 - Stop
                        gc_block.modal.program_flow = ProgramFlow::CompletedM2;
                        mg_word_bit                 = ModalGroup::MM4;
                        break;
                    case 30:
                        // M30 - End
                        gc_block.modal.program_flow = ProgramFlow::CompletedM30;
                        mg_word_bit                 = ModalGroup::MM4;
                        break;
                    case 3:
                    case 4:
                    case 5:
                        switch (int_value) {
                            case 3:
                                gc_block.modal.spindle = SpindleState::Cw;
                                break;
                            case 4:  // Supported if SPINDLE_DIR_PIN is defined or laser mode is on.
                                if (spindle->is_reversable || spindle->inLaserMode()) {
                                    gc_block.modal.spindle = SpindleState::Ccw;
                                } else {
                                    grbl_msg_sendf(CLIENT_SERIAL, MsgLevel::Info, "M4 requires laser mode or a reversable spindle");
                                    FAIL(Error::GcodeUnsupportedCommand);
                                }
                                break;
                            case 5:
                                gc_block.modal.spindle = SpindleState::Disable;
                                break;
                        }
                        mg_word_bit = ModalGroup::MM7;
                        break;
                    case 6:  // tool change
                        gc_block.modal.tool_change = ToolChange::Enable;
#ifdef USE_TOOL_CHANGE
                        //user_tool_change(gc_state.tool);
#endif
                        mg_word_bit = ModalGroup::MM6;
                        break;
                    case 7:
                    case 8:
                    case 9:
                        switch (int_value) {
#ifdef COOLANT_MIST_PIN
                            case 7:
                                gc_block.coolant = GCodeCoolant::M7;
                                break;
#endif
#ifdef COOLANT_FLOOD_PIN
                            case 8:
                                gc_block.coolant = GCodeCoolant::M8;
                                break;
#endif
                            case 9:
                                gc_block.coolant = GCodeCoolant::M9;
                                break;
                        }
                        mg_word_bit = ModalGroup::MM8;
                        break;
#ifdef ENABLE_PARKING_OVERRIDE_CONTROL
                    case 56:
                        gc_block.modal.override = Override::ParkingMotion;
                        mg_word_bit             = ModalGroup::MM9;
                        break;
#endif
                    case 62:
                        gc_block.modal.io_control = IoControl::DigitalOnSync;
                        mg_word_bit               = ModalGroup::MM10;
                        break;
                    case 63:
                        gc_block.modal.io_control = IoControl::DigitalOffSync;
                        mg_word_bit               = ModalGroup::MM10;
                        break;
                    case 64:
                        gc_block.modal.io_control = IoControl::DigitalOnImmediate;
                        mg_word_bit               = ModalGroup::MM10;
                        break;
                    case 65:
                        gc_block.modal.io_control = IoControl::DigitalOffImmediate;
                        mg_word_bit               = ModalGroup::MM10;
                        break;
                    case 67:
                        gc_block.modal.io_control = IoControl::SetAnalogSync;
                        mg_word_bit               = ModalGroup::MM10;
                        break;
                    case 68:
                        gc_block.modal.io_control = IoControl::SetAnalogImmediate;
                        mg_word_bit               = ModalGroup::MM10;
                        break;
                    default:
                        FAIL(Error::GcodeUnsupportedCommand);  // [Unsupported M command]
                }
                // Check for more than one command per modal group violations in the current block
                // NOTE: Variable 'mg_word_bit' is always assigned, if the command is valid.
                bitmask = bit(mg_word_bit);
                if (bit_istrue(command_words, bitmask)) {
                    FAIL(Error::GcodeModalGroupViolation);
                }
                command_words |= bitmask;
                break;
            // NOTE: All remaining letters assign values.
            default:
                /* Non-Command Words: This initial parsing phase only checks for repeats of the remaining
               legal g-code words and stores their value. Error-checking is performed later since some
               words (I,J,K,L,P,R) have multiple connotations and/or depend on the issued commands. */
                GCodeWord axis_word_bit;
                switch (letter) {
                    case 'A':
                        if (n_axis > A_AXIS) {
                            axis_word_bit               = GCodeWord::A;
                            gc_block.values.xyz[A_AXIS] = value;
                            axis_words |= bit(A_AXIS);
                        } else {
                            FAIL(Error::GcodeUnsupportedCommand);
                        }
                        break;
                    case 'B':
                        if (n_axis > B_AXIS) {
                            axis_word_bit               = GCodeWord::B;
                            gc_block.values.xyz[B_AXIS] = value;
                            axis_words |= bit(B_AXIS);
                        } else {
                            FAIL(Error::GcodeUnsupportedCommand);
                        }
                        break;
                    case 'C':
                        if (n_axis > C_AXIS) {
                            axis_word_bit               = GCodeWord::C;
                            gc_block.values.xyz[C_AXIS] = value;
                            axis_words |= bit(C_AXIS);
                        } else {
                            FAIL(Error::GcodeUnsupportedCommand);
                        }
                        break;
                    // case 'D': // Not supported
                    case 'E':
                        axis_word_bit     = GCodeWord::E;
                        gc_block.values.e = int_value;
                        //grbl_msg_sendf(CLIENT_SERIAL, MSG_LEVEL_INFO, "E %d", gc_block.values.e);
                        break;
                    case 'F':
                        axis_word_bit     = GCodeWord::F;
                        gc_block.values.f = value;
                        break;
                    // case 'H': // Not supported
                    case 'I':
                        axis_word_bit               = GCodeWord::I;
                        gc_block.values.ijk[X_AXIS] = value;
                        ijk_words |= bit(X_AXIS);
                        break;
                    case 'J':
                        axis_word_bit               = GCodeWord::J;
                        gc_block.values.ijk[Y_AXIS] = value;
                        ijk_words |= bit(Y_AXIS);
                        break;
                    case 'K':
                        axis_word_bit               = GCodeWord::K;
                        gc_block.values.ijk[Z_AXIS] = value;
                        ijk_words |= bit(Z_AXIS);
                        break;
                    case 'L':
                        axis_word_bit     = GCodeWord::L;
                        gc_block.values.l = int_value;
                        break;
                    case 'N':
                        axis_word_bit     = GCodeWord::N;
                        gc_block.values.n = trunc(value);
                        break;
                    case 'P':
                        axis_word_bit     = GCodeWord::P;
                        gc_block.values.p = value;
                        break;
                    case 'Q':
                        axis_word_bit     = GCodeWord::Q;
                        gc_block.values.q = value;
                        //grbl_msg_sendf(CLIENT_SERIAL, MSG_LEVEL_INFO, "Q %2.2f", value);
                        break;
                    case 'R':
                        axis_word_bit     = GCodeWord::R;
                        gc_block.values.r = value;
                        break;
                    case 'S':
                        axis_word_bit     = GCodeWord::S;
                        gc_block.values.s = value;
                        break;
                    case 'T':
                        axis_word_bit = GCodeWord::T;
                        if (value > MaxToolNumber) {
                            FAIL(Error::GcodeMaxValueExceeded);
                        }
                        grbl_msg_sendf(CLIENT_SERIAL, MsgLevel::Info, "Tool No: %d", int_value);
                        gc_state.tool = int_value;
                        break;
                    case 'X':
                        if (n_axis > X_AXIS) {
                            axis_word_bit               = GCodeWord::X;
                            gc_block.values.xyz[X_AXIS] = value;
                            axis_words |= bit(X_AXIS);

                        } else {
                            FAIL(Error::GcodeUnsupportedCommand);
                        }
                        break;
                    case 'Y':
                        if (n_axis > Y_AXIS) {
                            axis_word_bit               = GCodeWord::Y;
                            gc_block.values.xyz[Y_AXIS] = value;
                            axis_words |= bit(Y_AXIS);
                        } else {
                            FAIL(Error::GcodeUnsupportedCommand);
                        }
                        break;
                    case 'Z':
                        if (n_axis > Z_AXIS) {
                            axis_word_bit               = GCodeWord::Z;
                            gc_block.values.xyz[Z_AXIS] = value;
                            axis_words |= bit(Z_AXIS);
                        } else {
                            FAIL(Error::GcodeUnsupportedCommand);
                        }
                        break;
                    default:
                        FAIL(Error::GcodeUnsupportedCommand);
                }
                // NOTE: Variable 'axis_word_bit' is always assigned, if the non-command letter is valid.
                uint32_t bitmask = bit(axis_word_bit);
                if (bit_istrue(value_words, bitmask)) {
                    FAIL(Error::GcodeWordRepeated);  // [Word repeated]
                }
                // Check for invalid negative values for words F, N, P, T, and S.
                // NOTE: Negative value check is done here simply for code-efficiency.
                if (bitmask & (bit(GCodeWord::F) | bit(GCodeWord::N) | bit(GCodeWord::P) | bit(GCodeWord::T) | bit(GCodeWord::S))) {
                    if (value < 0.0) {
                        FAIL(Error::NegativeValue);  // [Word value cannot be negative]
                    }
                }
                value_words |= bitmask;  // Flag to indicate parameter assigned.
        }
    }
    // Parsing complete!
    /* -------------------------------------------------------------------------------------
       STEP 3: Error-check all commands and values passed in this block. This step ensures all of
       the commands are valid for execution and follows the NIST standard as closely as possible.
       If an error is found, all commands and values in this block are dumped and will not update
       the active system g-code modes. If the block is ok, the active system g-code modes will be
       updated based on the commands of this block, and signal for it to be executed.

       Also, we have to pre-convert all of the values passed based on the modes set by the parsed
       block. There are a number of error-checks that require target information that can only be
       accurately calculated if we convert these values in conjunction with the error-checking.
       This relegates the next execution step as only updating the system g-code modes and
       performing the programmed actions in order. The execution step should not require any
       conversion calculations and would only require minimal checks necessary to execute.
    */
    /* NOTE: At this point, the g-code block has been parsed and the block line can be freed.
       NOTE: It's also possible, at some future point, to break up STEP 2, to allow piece-wise
       parsing of the block on a per-word basis, rather than the entire block. This could remove
       the need for maintaining a large string variable for the entire block and free up some memory.
       To do this, this would simply need to retain all of the data in STEP 1, such as the new block
       data struct, the modal group and value bitflag tracking variables, and axis array indices
       compatible variables. This data contains all of the information necessary to error-check the
       new g-code block when the EOL character is received. However, this would break Grbl's startup
       lines in how it currently works and would require some refactoring to make it compatible.
    */
    // [0. Non-specific/common error-checks and miscellaneous setup]:
    // Determine implicit axis command conditions. Axis words have been passed, but no explicit axis
    // command has been sent. If so, set axis command to current motion mode.
    if (axis_words) {
        if (axis_command == AxisCommand::None) {
            axis_command = AxisCommand::MotionMode;  // Assign implicit motion-mode
        }
    }
    // Check for valid line number N value.
    if (bit_istrue(value_words, bit(GCodeWord::N))) {
        // Line number value cannot be less than zero (done) or greater than max line number.
        if (gc_block.values.n > MaxLineNumber) {
            FAIL(Error::GcodeInvalidLineNumber);  // [Exceeds max line number]
        }
    }
    // bit_false(value_words,bit(GCodeWord::N)); // NOTE: Single-meaning value word. Set at end of error-checking.
    // Track for unused words at the end of error-checking.
    // NOTE: Single-meaning value words are removed all at once at the end of error-checking, because
    // they are always used when present. This was done to save a few bytes of flash. For clarity, the
    // single-meaning value words may be removed as they are used. Also, axis words are treated in the
    // same way. If there is an explicit/implicit axis command, XYZ words are always used and are
    // are removed at the end of error-checking.
    // [1. Comments ]: MSG's NOT SUPPORTED. Comment handling performed by protocol.
    // [2. Set feed rate mode ]: G93 F word missing with G1,G2/3 active, implicitly or explicitly. Feed rate
    //   is not defined after switching to G94 from G93.
    // NOTE: For jogging, ignore prior feed rate mode. Enforce G94 and check for required F word.
    if (gc_parser_flags & GCParserJogMotion) {
        if (bit_isfalse(value_words, bit(GCodeWord::F))) {
            FAIL(Error::GcodeUndefinedFeedRate);
        }
        if (gc_block.modal.units == Units::Inches) {
            gc_block.values.f *= MM_PER_INCH;
        }
    } else {
        if (gc_block.modal.feed_rate == FeedRate::InverseTime) {  // = G93
            // NOTE: G38 can also operate in inverse time, but is undefined as an error. Missing F word check added here.
            if (axis_command == AxisCommand::MotionMode) {
                if ((gc_block.modal.motion != Motion::None) || (gc_block.modal.motion != Motion::Seek)) {
                    if (bit_isfalse(value_words, bit(GCodeWord::F))) {
                        FAIL(Error::GcodeUndefinedFeedRate);  // [F word missing]
                    }
                }
            }
            // NOTE: It seems redundant to check for an F word to be passed after switching from G94 to G93. We would
            // accomplish the exact same thing if the feed rate value is always reset to zero and undefined after each
            // inverse time block, since the commands that use this value already perform undefined checks. This would
            // also allow other commands, following this switch, to execute and not error out needlessly. This code is
            // combined with the above feed rate mode and the below set feed rate error-checking.
            // [3. Set feed rate ]: F is negative (done.)
            // - In inverse time mode: Always implicitly zero the feed rate value before and after block completion.
            // NOTE: If in G93 mode or switched into it from G94, just keep F value as initialized zero or passed F word
            // value in the block. If no F word is passed with a motion command that requires a feed rate, this will error
            // out in the motion modes error-checking. However, if no F word is passed with NO motion command that requires
            // a feed rate, we simply move on and the state feed rate value gets updated to zero and remains undefined.
        } else {  // = G94
            // - In units per mm mode: If F word passed, ensure value is in mm/min, otherwise push last state value.
            if (gc_state.modal.feed_rate == FeedRate::UnitsPerMin) {  // Last state is also G94
                if (bit_istrue(value_words, bit(GCodeWord::F))) {
                    if (gc_block.modal.units == Units::Inches) {
                        gc_block.values.f *= MM_PER_INCH;
                    }
                } else {
                    gc_block.values.f = gc_state.feed_rate;  // Push last state feed rate
                }
            }  // Else, switching to G94 from G93, so don't push last state feed rate. Its undefined or the passed F word value.
        }
    }
    // bit_false(value_words,bit(GCodeWord::F)); // NOTE: Single-meaning value word. Set at end of error-checking.
    // [4. Set spindle speed ]: S is negative (done.)
    if (bit_isfalse(value_words, bit(GCodeWord::S))) {
        gc_block.values.s = gc_state.spindle_speed;
        // bit_false(value_words,bit(GCodeWord::S)); // NOTE: Single-meaning value word. Set at end of error-checking.
        // [5. Select tool ]: NOT SUPPORTED. Only tracks value. T is negative (done.) Not an integer. Greater than max tool value.
        // bit_false(value_words,bit(GCodeWord::T)); // NOTE: Single-meaning value word. Set at end of error-checking.
        // [6. Change tool ]: N/A
        // [7. Spindle control ]: N/A
        // [8. Coolant control ]: N/A
        // [9. Enable/disable feed rate or spindle overrides ]: NOT SUPPORTED.
    }
#ifdef ENABLE_PARKING_OVERRIDE_CONTROL
    if (bit_istrue(command_words, bit(ModalGroup::MM9))) {  // Already set as enabled in parser.
        if (bit_istrue(value_words, bit(GCodeWord::P))) {
            if (gc_block.values.p == 0.0) {
                gc_block.modal.override = Override::Disabled;
            }
            bit_false(value_words, bit(GCodeWord::P));
        }
    }
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
