scottbez1/Grbl_Esp32/Grbl_Esp32/src/Protocol.cpp

/*
  Protocol.cpp - controls Grbl execution protocol and procedures
  Part of Grbl

  Copyright (c) 2011-2016 Sungeun K. Jeon for Gnea Research LLC
  Copyright (c) 2009-2011 Simen Svale Skogsrud

	2018 -	Bart Dring This file was modifed for use on the ESP32
					CPU. Do not use this with Grbl for atMega328P

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
  You should have received a copy of the GNU General Public License
  along with Grbl.  If not, see <http://www.gnu.org/licenses/>.
*/

#include "Grbl.h"

static void protocol_exec_rt_suspend();

static char    line[LINE_BUFFER_SIZE];     // Line to be executed. Zero-terminated.
static char    comment[LINE_BUFFER_SIZE];  // Line to be executed. Zero-terminated.
static uint8_t line_flags           = 0;
static uint8_t char_counter         = 0;
static uint8_t comment_char_counter = 0;

typedef struct {
    char buffer[LINE_BUFFER_SIZE];
    int  len;
    int  line_number;
} client_line_t;
client_line_t client_lines[CLIENT_COUNT];

static void empty_line(uint8_t client) {
    client_line_t* cl = &client_lines[client];
    cl->len           = 0;
    cl->buffer[0]     = '\0';
}
static void empty_lines() {
    for (uint8_t client = 0; client < CLIENT_COUNT; client++) {
        empty_line(client);
    }
}

Error add_char_to_line(char c, uint8_t client) {
    client_line_t* cl = &client_lines[client];
    // Simple editing for interactive input
    if (c == '\b') {
        // Backspace erases
        if (cl->len) {
            --cl->len;
            cl->buffer[cl->len] = '\0';
        }
        return Error::Ok;
    }
    if (cl->len == (LINE_BUFFER_SIZE - 1)) {
        return Error::Overflow;
    }
    if (c == '\r' || c == '\n') {
        cl->len = 0;
        cl->line_number++;
        return Error::Eol;
    }
    cl->buffer[cl->len++] = c;
    cl->buffer[cl->len]   = '\0';
    return Error::Ok;
}

Error execute_line(char* line, uint8_t client, WebUI::AuthenticationLevel auth_level) {
    Error result = Error::Ok;
    // Empty or comment line. For syncing purposes.
    if (line[0] == 0) {
        return Error::Ok;
    }
    // Grbl '$' or WebUI '[ESPxxx]' system command
    if (line[0] == '$' || line[0] == '[') {
        return system_execute_line(line, client, auth_level);
    }
    // Everything else is gcode. Block if in alarm or jog mode.
    if (sys.state == State::Alarm || sys.state == State::Jog) {
        return Error::SystemGcLock;
    }
    return gc_execute_line(line, client);
}

bool can_park() {
    return
#ifdef ENABLE_PARKING_OVERRIDE_CONTROL
        sys.override_ctrl == Override::ParkingMotion &&
#endif
        homing_enable->get() && !spindle->inLaserMode();
}

/*
  GRBL PRIMARY LOOP:
*/
void protocol_main_loop() {
    serial_reset_read_buffer(CLIENT_ALL);
    empty_lines();
    //uint8_t client = CLIENT_SERIAL; // default client
    // Perform some machine checks to make sure everything is good to go.
#ifdef CHECK_LIMITS_AT_INIT
    if (hard_limits->get()) {
        if (limits_get_state()) {
            sys.state = State::Alarm;  // Ensure alarm state is active.
            report_feedback_message(Message::CheckLimits);
        }
    }
#endif
    // Check for and report alarm state after a reset, error, or an initial power up.
    // NOTE: Sleep mode disables the stepper drivers and position can't be guaranteed.
    // Re-initialize the sleep state as an ALARM mode to ensure user homes or acknowledges.
    if (sys.state == State::Alarm || sys.state == State::Sleep) {
        report_feedback_message(Message::AlarmLock);
        sys.state = State::Alarm;  // Ensure alarm state is set.
    } else {
        // Check if the safety door is open.
        sys.state = State::Idle;
        if (system_check_safety_door_ajar()) {
            sys_rt_exec_state.bit.safetyDoor = true;
            protocol_execute_realtime();  // Enter safety door mode. Should return as IDLE state.
        }
        // All systems go!
        system_execute_startup(line);  // Execute startup script.
    }
    // ---------------------------------------------------------------------------------
    // Primary loop! Upon a system abort, this exits back to main() to reset the system.
    // This is also where Grbl idles while waiting for something to do.
    // ---------------------------------------------------------------------------------
    uint8_t c;
    for (;;) {
#ifdef ENABLE_SD_CARD
        if (SD_ready_next) {
            char fileLine[255];
            if (readFileLine(fileLine, 255)) {
                SD_ready_next = false;
                report_status_message(execute_line(fileLine, SD_client, SD_auth_level), SD_client);
            } else {
                char temp[50];
                sd_get_current_filename(temp);
                grbl_notifyf("SD print done", "%s print is successful", temp);
                closeFile();  // close file and clear SD ready/running flags
            }
        }
#endif
        // Receive one line of incoming serial data, as the data becomes available.
        // Filtering, if necessary, is done later in gc_execute_line(), so the
        // filtering is the same with serial and file input.
        uint8_t client = CLIENT_SERIAL;
        char*   line;
        for (client = 0; client < CLIENT_COUNT; client++) {
            while ((c = serial_read(client)) != SERIAL_NO_DATA) {
                Error res = add_char_to_line(c, client);
                switch (res) {
                    case Error::Ok:
                        break;
                    case Error::Eol:
                        protocol_execute_realtime();  // Runtime command check point.
                        if (sys.abort) {
                            return;  // Bail to calling function upon system abort
                        }
                        line = client_lines[client].buffer;
#ifdef REPORT_ECHO_RAW_LINE_RECEIVED
                        report_echo_line_received(line, client);
#endif
                        // auth_level can be upgraded by supplying a password on the command line
                        report_status_message(execute_line(line, client, WebUI::AuthenticationLevel::LEVEL_GUEST), client);
                        empty_line(client);
                        break;
                    case Error::Overflow:
                        report_status_message(Error::Overflow, client);
                        empty_line(client);
                        break;
                    default:
                        break;
                }
            }  // while serial read
        }      // for clients
        // If there are no more characters in the serial read buffer to be processed and executed,
        // this indicates that g-code streaming has either filled the planner buffer or has
        // completed. In either case, auto-cycle start, if enabled, any queued moves.
        protocol_auto_cycle_start();
        protocol_execute_realtime();  // Runtime command check point.
        if (sys.abort) {
            return;  // Bail to main() program loop to reset system.
        }
        // check to see if we should disable the stepper drivers ... esp32 work around for disable in main loop.
        if (stepper_idle) {
            if (esp_timer_get_time() > stepper_idle_counter) {
                motors_set_disable(true);
            }
        }
    }
    return; /* Never reached */
}

// Block until all buffered steps are executed or in a cycle state. Works with feed hold
// during a synchronize call, if it should happen. Also, waits for clean cycle end.
void protocol_buffer_synchronize() {
    // If system is queued, ensure cycle resumes if the auto start flag is present.
    protocol_auto_cycle_start();
    do {
        protocol_execute_realtime();  // Check and execute run-time commands
        if (sys.abort) {
            return;  // Check for system abort
        }
    } while (plan_get_current_block() || (sys.state == State::Cycle));
}

// Auto-cycle start triggers when there is a motion ready to execute and if the main program is not
// actively parsing commands.
// NOTE: This function is called from the main loop, buffer sync, and mc_line() only and executes
// when one of these conditions exist respectively: There are no more blocks sent (i.e. streaming
// is finished, single commands), a command that needs to wait for the motions in the buffer to
// execute calls a buffer sync, or the planner buffer is full and ready to go.
void protocol_auto_cycle_start() {
    if (plan_get_current_block() != NULL) {       // Check if there are any blocks in the buffer.
        sys_rt_exec_state.bit.cycleStart = true;  // If so, execute them!
    }
}

// This function is the general interface to Grbl's real-time command execution system. It is called
// from various check points in the main program, primarily where there may be a while loop waiting
// for a buffer to clear space or any point where the execution time from the last check point may
// be more than a fraction of a second. This is a way to execute realtime commands asynchronously
// (aka multitasking) with grbl's g-code parsing and planning functions. This function also serves
// as an interface for the interrupts to set the system realtime flags, where only the main program
// handles them, removing the need to define more computationally-expensive volatile variables. This
// also provides a controlled way to execute certain tasks without having two or more instances of
// the same task, such as the planner recalculating the buffer upon a feedhold or overrides.
// NOTE: The sys_rt_exec_state.bit variable flags are set by any process, step or serial interrupts, pinouts,
// limit switches, or the main program.
void protocol_execute_realtime() {
    protocol_exec_rt_system();
    if (sys.suspend.value) {
        protocol_exec_rt_suspend();
    }
}
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
