scottbez1/Grbl_Esp32/Grbl_Esp32/src/Serial.cpp

/*
  Serial.cpp - Header for system level commands and real-time processes
  Part of Grbl
  Copyright (c) 2014-2016 Sungeun K. Jeon for Gnea Research LLC

	2018 -	Bart Dring This file was modified for use on the ESP32
					CPU. Do not use this with Grbl for atMega328P

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
  What is going on here?

  Original Grbl only supports communication via serial port. That is why this
  file is call serial.cpp. Grbl_ESP32 supports many "clients".

  Clients are sources of commands like the serial port or a bluetooth connection.
  Multiple clients can be active at a time. If a client asks for status, only the client will
  receive the reply to the command.

  The serial port acts as the debugging port because it is always on and does not
  need to be reconnected after reboot. Messages about the configuration and other events
  are sent to the serial port automatically, without a request command. These are in the
  [MSG: xxxxxx] format. Gcode senders are should be OK with this because Grbl has always
  send some messages like this.

  Important: It is up user that the clients play well together. Ideally, if one client
  is sending the gcode, the others should just be doing status, feedhold, etc.

  Clients send gcode, grbl commands ($$, [ESP...], etc) and realtime commands (?,!.~, etc)
  Gcode and Grbl commands are a string of printable characters followed by a '\r' or '\n'
  Realtime commands are single characters with no '\r' or '\n'

  After sending a gcode or grbl command, you must wait for an OK to send another.
  This is because only a certain number of commands can be buffered at a time.
  Grbl will tell you when it is ready for another one with the OK.

  Realtime commands can be sent at any time and will acted upon very quickly.
  Realtime commands can be anywhere in the stream.

  To allow the realtime commands to be randomly mixed in the stream of data, we
  read all clients as fast as possible. The realtime commands are acted upon and the other charcters are
  placed into a client_buffer[client].

  The main protocol loop reads from client_buffer[]


*/

#include "Grbl.h"

portMUX_TYPE myMutex = portMUX_INITIALIZER_UNLOCKED;

static TaskHandle_t serialCheckTaskHandle = 0;

WebUI::InputBuffer client_buffer[CLIENT_COUNT];  // create a buffer for each client

// Returns the number of bytes available in a client buffer.
uint8_t serial_get_rx_buffer_available(uint8_t client) {
    return client_buffer[client].availableforwrite();
}

void heapCheckTask(void* pvParameters) {
    static uint32_t heapSize = 0;
    while (true) {
        uint32_t newHeapSize = xPortGetFreeHeapSize();
        if (newHeapSize != heapSize) {
            heapSize = newHeapSize;
            grbl_msg_sendf(CLIENT_SERIAL, MsgLevel::Info, "heap %d", heapSize);
        }
        vTaskDelay(3000 / portTICK_RATE_MS);  // Yield to other tasks

        static UBaseType_t uxHighWaterMark = 0;
#ifdef DEBUG_TASK_STACK
        reportTaskStackSize(uxHighWaterMark);
#endif
    }
}

void serial_init() {
#ifdef DEBUG_REPORT_HEAP_SIZE
    // For a 2000-word stack, uxTaskGetStackHighWaterMark reports 288 words available
    xTaskCreatePinnedToCore(heapCheckTask, "heapTask", 2000, NULL, 1, NULL, 1);
#endif

    Serial.begin(BAUD_RATE);
    Serial.setRxBufferSize(256);
    // reset all buffers
    serial_reset_read_buffer(CLIENT_ALL);
    grbl_send(CLIENT_SERIAL, "\r\n");  // create some white space after ESP32 boot info
    serialCheckTaskHandle = 0;
    // create a task to check for incoming data
    // For a 4096-word stack, uxTaskGetStackHighWaterMark reports 244 words available
    // after WebUI attaches.
    xTaskCreatePinnedToCore(serialCheckTask,    // task
                            "serialCheckTask",  // name for task
                            4096,               // size of task stack
                            NULL,               // parameters
                            1,                  // priority
                            &serialCheckTaskHandle,
                            SUPPORT_TASK_CORE  // must run the task on same core
                                               // core
    );
}

// this task runs and checks for data on all interfaces
// REaltime stuff is acted upon, then characters are added to the appropriate buffer
void serialCheckTask(void* pvParameters) {
    uint8_t            data            = 0;
    uint8_t            client          = CLIENT_ALL;  // who sent the data
    static UBaseType_t uxHighWaterMark = 0;
    while (true) {  // run continuously
        while (any_client_has_data()) {
            if (Serial.available()) {
                client = CLIENT_SERIAL;
                data   = Serial.read();
            } else if (WebUI::inputBuffer.available()) {
                client = CLIENT_INPUT;
                data   = WebUI::inputBuffer.read();
            } else {
                //currently is wifi or BT but better to prepare both can be live
#ifdef ENABLE_BLUETOOTH
                if (WebUI::SerialBT.hasClient() && WebUI::SerialBT.available()) {
                    client = CLIENT_BT;
                    data   = WebUI::SerialBT.read();

                    // Serial.write(data);  // echo all data to serial.
                } else {
#endif
#if defined(ENABLE_WIFI) && defined(ENABLE_HTTP) && defined(ENABLE_SERIAL2SOCKET_IN)
                    if (WebUI::Serial2Socket.available()) {
                        client = CLIENT_WEBUI;
                        data   = WebUI::Serial2Socket.read();
                    } else {
#endif
#if defined(ENABLE_WIFI) && defined(ENABLE_TELNET)
                        if (WebUI::telnet_server.available()) {
                            client = CLIENT_TELNET;
                            data   = WebUI::telnet_server.read();
                        }
#endif
#if defined(ENABLE_WIFI) && defined(ENABLE_HTTP) && defined(ENABLE_SERIAL2SOCKET_IN)
                    }
#endif
#ifdef ENABLE_BLUETOOTH
                }
#endif
            }
            // Pick off realtime command characters directly from the serial stream. These characters are
            // not passed into the main buffer, but these set system state flag bits for realtime execution.
            if (is_realtime_command(data)) {
                execute_realtime_command(static_cast<Cmd>(data), client);
            } else {
                if (get_sd_state(false) == SDCARD_IDLE) {
                    vTaskEnterCritical(&myMutex);
                    client_buffer[client].write(data);
                    vTaskExitCritical(&myMutex);
                } else {
                    if (data == '\r' || data == '\n') {
                        grbl_sendf(client, "error %d\r\n", Error::AnotherInterfaceBusy);
                        grbl_msg_sendf(client, MsgLevel::Info, "SD card job running");
                    }
                }
            }
        }  // if something available
        WebUI::COMMANDS::handle();
#ifdef ENABLE_WIFI
        WebUI::wifi_config.handle();
#endif
#ifdef ENABLE_BLUETOOTH
        WebUI::bt_config.handle();
#endif
#if defined(ENABLE_WIFI) && defined(ENABLE_HTTP) && defined(ENABLE_SERIAL2SOCKET_IN)
        WebUI::Serial2Socket.handle_flush();
#endif
        vTaskDelay(1 / portTICK_RATE_MS);  // Yield to other tasks

        static UBaseType_t uxHighWaterMark = 0;
#ifdef DEBUG_TASK_STACK
        reportTaskStackSize(uxHighWaterMark);
#endif
    }
}

void serial_reset_read_buffer(uint8_t client) {
    for (uint8_t client_num = 0; client_num < CLIENT_COUNT; client_num++) {
        if (client == client_num || client == CLIENT_ALL) {
            client_buffer[client_num].begin();
        }
    }
}

// Writes one byte to the TX serial buffer. Called by main program.
void serial_write(uint8_t data) {
    Serial.write((char)data);
}

// Fetches the first byte in the serial read buffer. Called by protocol loop.
uint8_t serial_read(uint8_t client) {
    uint8_t data;
    vTaskEnterCritical(&myMutex);
    if (client_buffer[client].available()) {
        data = client_buffer[client].read();
        vTaskExitCritical(&myMutex);
        //Serial.write((char)data);
        return data;
    } else {
        vTaskExitCritical(&myMutex);
        return SERIAL_NO_DATA;
    }
}

bool any_client_has_data() {
    return (Serial.available() || WebUI::inputBuffer.available()
#ifdef ENABLE_BLUETOOTH
            || (WebUI::SerialBT.hasClient() && WebUI::SerialBT.available())
#endif
#if defined(ENABLE_WIFI) && defined(ENABLE_HTTP) && defined(ENABLE_SERIAL2SOCKET_IN)
            || WebUI::Serial2Socket.available()
#endif
#if defined(ENABLE_WIFI) && defined(ENABLE_TELNET)
            || WebUI::telnet_server.available()
#endif
    );
}

// checks to see if a character is a realtime character
bool is_realtime_command(uint8_t data) {
    if (data >= 0x80) {
        return true;
    }
    auto cmd = static_cast<Cmd>(data);
    return cmd == Cmd::Reset || cmd == Cmd::StatusReport || cmd == Cmd::CycleStart || cmd == Cmd::FeedHold;
}
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
