scottbez1/Grbl_Esp32/(commit log)

2020-12-04 WIP spindle rewrite
2020-12-09 Fix alarm during motion
    [VFDSpindle.cpp, workbee.h]
2020-12-09 Fix crash during door
    [VFDSpindle.cpp]
2020-12-20 ESTOP (via custom hard limit) and correct squaring
    [Limits.cpp, workbee.h]
2020-12-22 Initial schematic
    [workbeeController.kicad_pcb, workbeeController.sch]
2020-12-23 Schematic updates
    [workbeeController.sch]
2020-12-23 SPI Shift Register Input support
2020-12-27 Add basic flow pulse counter and shift register limits support
2020-12-27 Initial schematic and footprints complete
    [workbeeController.sch]
2020-12-28 Change to pin headers, start PCB
    [workbeeController.sch]
2020-12-29 PCB routed
    [workbeeController.kicad_pcb, workbeeController.sch]
2020-12-29 Change resistor footprints, add ground/chassis jumper
    [workbeeController.kicad_pcb, workbeeController.sch]
